rpeter3/toilet_kat_change/toilet_kat_change/toilet_kat_change.ino

#include <BLEServer.h>
#include <BLEDevice.h>
#include <BLEUtils.h>
#include <Wire.h>
#include <Adafruit_MCP23X17.h>
#include <DualMAX14870MotorShield.h> // Include the motor driver library
#include <PID_v1_bc.h>               // Heater temperature PID
#include <EEPROM.h>     // Include EEPROM library for parameter persistence
#include <esp_ota_ops.h>  // Include OTA operations for updates
#include <esp_image_format.h>
#include <nvs_flash.h>   // Include NVS for rollback state storage
#include <nvs.h>
#include <esp_system.h>  // Include for reboot functionality
#include <esp_sleep.h>    // Include for deep sleep and wake
#include <driver/rtc_io.h> // RTC GPIO for wake pin pull-up in deep sleep
#include <driver/gpio.h>   // GPIO hold during deep sleep (fan PWM pin)
#include <esp_task_wdt.h>
#include <mbedtls/md5.h> // Include for MD5 validation
#include <mbedtls/base64.h>
#include <LittleFS.h>
#include "esp_flash.h"
#include <esp_core_dump.h>
#include <esp_partition.h>
#include "ota_diag_types.h"
#define LED_PHASE_COUNT 5

// Error log (LittleFS storage partition, bounded, BLE-retrievable)
#define LOG_FILE "/errors.txt"
#define STORAGE_PARTITION_LABEL "storage"
#define MAX_LOG_SIZE 204800
#define LOG_HEADROOM 25600
#define LOG_SLEEP_TRIM_TRIGGER (MAX_LOG_SIZE - LOG_HEADROOM)
#define LOG_TRIM_TARGET 153600
#define OTA_PREP_LOG_TRIM_TARGET 102400
#define LOG_TRIM_TEMP_FILE "/errors.tmp"
#define LOG_TRIM_COPY_CHUNK 512
#define LOG_CHUNK_SIZE 450
#define LOG_LINE_MAX_LEN 200
#define CORE_CHUNK_RAW 336

//########################################################################
// Uncomment to test heater fail-safe WDT recovery: stops TWDT feed during flush while heater is on.
// Expect task-WDT reset within 5 s of heating phase, forensics on Serial/storage after reboot.
//#define SIMULATE_WDT_HANG
//########################################################################



// Pin and component definitions
const int heaterPin = 17;        // GPIO17 (HEATER)

const int buzzerPin = 38;        // GPIO38 (BUZ)
const int microswitchClosePin = 16;   // GPIO16
const int microswitchOpenPin = 15;    // GPIO15
const int controlPanelWake = 2;       // GPIO2 - wake/button1 (direct to main board)

// Motor current monitoring
const int m1CurrentPin = 8;     // GPIO8 (M1_A) - Current sense output

// Heater current monitoring
const int heaterCurrentPin = 12; // GPIO12 (HS_OUT) - Heater current sense output from INA169

// Battery voltage monitoring
const int batteryVoltagePin = 10;  // GPIO10 (VMON) - Battery voltage monitoring
const int batteryTempPin = 5;      // GPIO5 (B_TEMP) - Battery temperature monitoring

// Custom I2C instance
TwoWire myI2C = TwoWire(0);

// MCP23017 setup
Adafruit_MCP23X17 mcp;
bool mcpInitialized = false;
unsigned long lastMcpUnavailableLogMillis = 0;
const unsigned long MCP_UNAVAILABLE_LOG_INTERVAL_MS = 5000;

int lastFanState = 0;  // 0=off, 1=forward, -1=reverse (for error log context)
bool errorLogInitialized = false;

#define SERVICE_UUID "5636340f-afc7-47b1-b0a8-15bc9d7d29a5"
#define CHARACTERISTIC_UUID "c327b077-560f-46a1-8f35-b4ab0332fea0"
#define SERIAL_CHARACTERISTIC_UUID "c327b077-560f-46a1-8f35-b4ab0332fea1"
#define BLE_FRAME_START_BYTE 0x7E
#define BLE_FRAME_HEADER_SIZE 3
#define VERSION_CHARACTERISTIC_UUID "c327b077-560f-46a1-8f35-b4ab0332fea2"
#define UPDATE_SERVICE_UUID "5636340f-afc7-47b1-b0a8-15bcb9d7d29a6"
#define UPDATE_CHARACTERISTIC_UUID "c327b077-560f-46a1-8f35-b4ab0332fea3"
#define RESPONSE_CHARACTERISTIC_UUID "c327b077-560f-46a1-8f35-b4ab0332fea4"
#define PARAM_READ_CHARACTERISTIC_UUID "c327b077-560f-46a1-8f35-b4ab0332fea5"
#define PARAM_WRITE_CHARACTERISTIC_UUID "c327b077-560f-46a1-8f35-b4ab0332fea6"

// BLE Server global variables
BLECharacteristic * blue_characteristic;
BLECharacteristic * response_characteristic;
BLECharacteristic * param_read_characteristic;
BLECharacteristic * param_write_characteristic;
BLECharacteristic * serial_characteristic;
BLECharacteristic * version_characteristic;
BLECharacteristic * update_characteristic;
BLEServer * blue_server;
BLEService * update_service;
bool is_device_connected, old_device_connect = false;
bool serial_streaming_enabled = false;

// Trust handshake state (BLE_APP_MIGRATION_SPEC, BLE_HANDSHAKE_INTERFACE_SPEC)
enum TrustState {
  TRUST_STATE_UNTRUSTED = 0,
  TRUST_STATE_WAITING = 1,
  TRUST_STATE_TRUSTED = 2,
  TRUST_STATE_TIMEOUT = 3
};
static TrustState g_trustState = TRUST_STATE_UNTRUSTED;
static unsigned long g_trustStartMs = 0;
static const unsigned long TRUST_TIMEOUT_MS = 60000;  // 60s per spec

void resetTrustState();
void beginTrustWaiting();
void onTrustConfirmedByFlushButton();
void updateTrustTimeout();
bool isTrustedConnection();
void trustDoubleBeep();

// EEPROM configuration
#define EEPROM_SIZE 512
#define PARAM_START_ADDR 0
#define PARAM_MAGIC_NUMBER 0x1234
#define PARAM_COUNT 30
#define HW_VERSION_ADDR 200
#define HW_VERSION_MAGIC 0xFADE
#define FLUSH_COUNT_MAGIC_ADDR 300
#define FLUSH_COUNT_ADDR (FLUSH_COUNT_MAGIC_ADDR + sizeof(uint16_t))
#define FLUSH_COUNT_MAGIC 0xF1C5

// Hardware matrix persistence (NVS)
#define HW_MATRIX_MAGIC 0x484D4154UL  // "HMAT"
#define HW_MATRIX_SCHEMA_VERSION 1
#define HW_COMPONENT_VERSION_LEN 24
#define HW_COMPONENT_DESC_LEN 96
#define HW_COMPONENT_DATE_LEN 11  // YYYY-MM-DD + '\0'

// HWCFG transactional profile storage
#define HWCFG_MAGIC 0x48434647UL  // "HCFG"
#define HWCFG_SCHEMA_VERSION 1
#define HWCFG_PROFILE_MAX 24
#define HWCFG_PROFILE_ID_LEN 24
#define HWCFG_PROFILE_PARAM_BLOB_LEN 320
#define HWCFG_CONFIG_NAMESPACE "hwcfg"
#define HWCFG_ACTIVE_KEY "active"
#define HWCFG_LAST_GOOD_KEY "lkg"
#define HWCFG_ACTIVE_FILE "/hwcfg_active.bin"
#define HWCFG_LAST_GOOD_FILE "/hwcfg_lkg.bin"

// Version information
struct VersionInfo {
  uint16_t magic;
  uint16_t hardware_version;
  char hardware_description[32];
};

enum HardwareComponentId {
  HW_CONTROL_PANEL = 0,
  HW_HEATING_ELEMENT,
  HW_MAIN_CIRCUIT_BOARD,
  HW_VACUUM_FAN,
  HW_FEED_MOTOR,
  HW_MECHANISM_MOTOR,
  HW_THERMISTOR,
  HW_BATTERY,
  HW_FACTORY_SOFTWARE_DATE,
  HW_SOFTWARE_VERSION_NUMBER,
  HW_COMPONENT_COUNT
};

// Production: 0 = use hardware matrix (CONTROL_PANEL 5/6). Dev: pass -DCONTROL_PANEL_PINOUT_OVERRIDE=6 at build.
#ifndef CONTROL_PANEL_PINOUT_OVERRIDE
#define CONTROL_PANEL_PINOUT_OVERRIDE 0
#endif

enum ControlPanelPinout : uint8_t {
  CP_PINOUT_V5_LEGACY = 5,
  CP_PINOUT_V6 = 6
};

const int CP_V5_BTN2_MCP = 15;
const int CP_V6_BTN1_MCP = 6;
const int CP_V6_BTN2_MCP = 14;

struct HardwareComponentEntry {
  char current_version[HW_COMPONENT_VERSION_LEN];
  char current_description[HW_COMPONENT_DESC_LEN];
  char install_date[HW_COMPONENT_DATE_LEN];
  char previous_version[HW_COMPONENT_VERSION_LEN];
  char previous_description[HW_COMPONENT_DESC_LEN];
  char previous_install_date[HW_COMPONENT_DATE_LEN];
};

struct HardwareMatrix {
  uint32_t matrix_magic;
  uint16_t matrix_schema_version;
  uint16_t component_count;
  HardwareComponentEntry components[HW_COMPONENT_COUNT];
  uint32_t crc32;
};

struct HWCFGProfileEntry {
  uint8_t in_use;
  char profile_id[HWCFG_PROFILE_ID_LEN];
  char component_name[HW_COMPONENT_DESC_LEN];
  char component_version[HW_COMPONENT_VERSION_LEN];
  char params_blob[HWCFG_PROFILE_PARAM_BLOB_LEN];
};

struct HWCFGConfigStore {
  uint32_t magic;
  uint16_t schema_version;
  uint16_t profile_count;
  char active_profile_id[HWCFG_PROFILE_ID_LEN];
  char last_good_profile_id[HWCFG_PROFILE_ID_LEN];
  uint8_t active_validated;
  HWCFGProfileEntry profiles[HWCFG_PROFILE_MAX];
  uint32_t crc32;
};

//++++++++++++++++++++++++++++++++++++++++++++++++++++++++++++++++++++++++++++++++
//++++++++++++++++++++++++++++++++++++++++++++++++++++++++++++++++++++++++++++++++
//set this when building the firmware
//++++++++++++++++++++++++++++++++++++++++++++++++++++++++++++++++++++++++++++++++
//++++++++++++++++++++++++++++++++++++++++++++++++++++++++++++++++++++++++++++++++
const char* SOFTWARE_VERSION_NUMBER = "4.0.15";
const char* FACTORY_SOFTWARE_DATE = "2026-06-13";
const char* SOFTWARE_BUILD_DATE = __DATE__ " " __TIME__;

// Forward declarations
// sendSerialToBLEImpl: setValue+notify (ungated) — use only for AUTH or internal plumbing.
// sendSerialToBLE: gated on serial_streaming_enabled
void sendSerialToBLEImpl(const String& message);
void sendSerialToBLEImpl(float value);
void sendSerialToBLEImpl(int value);
void sendSerialToBLEImpl(unsigned long value);
void sendSerialToBLE(const String& message);
void sendSerialToBLE(float value);
void sendSerialToBLE(int value);
void sendSerialToBLE(unsigned long value);
void writeResponseToChannel(const String& response);
String buildParamCSV();
String buildMotorFaultStatusSnapshot();
void saveParametersToEEPROM();
void loadParametersFromEEPROM();
void loadFlushCountFromEEPROM();
bool saveFlushCountToEEPROM();
void incrementFlushCount();
void initializeHardwareVersion();
VersionInfo readHardwareVersion();
void writeHardwareVersion(uint16_t version, const char* description);
bool initializeHardwareMatrix();
String getVersionString();
String getHardwareComponentsListString();
String getHardwareComponentString(HardwareComponentId componentId);
bool setHardwareComponentByName(const String& componentName, const String& version, const String& installDate, const String& description, String& errorCode);
ControlPanelPinout getControlPanelPinout();
void configureControlPanelMcpInputs();
void configureControlPanelLedOutputs();
const int* getActiveLedPins();
int getLedPin(int uiIndex);
void logControlPanelPinout();
bool readControlPanelButton1();
bool readControlPanelButton2();
bool readControlPanelWakeLine();
bool readFlushCancelInput(bool button1Pressed, bool button2Pressed);
bool lookupHardwareComponentId(const String& componentName, HardwareComponentId& outId);
bool initializeHWCFGStore();
String handleHWCFGCommand(const String& cmd);
void enterEEPROMInvalidErrorState(const char* reason);
void initErrorLog();
void logBootCheckpoint(const char* phase);
void resetBootTiming();
void logBootTiming(const char* phase);
void captureCrashPendingRtc();
void flushPendingCrashLog();
void logCoredumpStatus();
String buildBootInfoResponse();
String readCoredumpChunk(size_t offset);
bool clearCoredumpImage();
void logError(const char* type, int code, const char* msg);
void logError(const char* type, int code, const char* msg, bool includeContext);
bool trimErrorLogToSize(size_t targetBytes);
void logDevFlush(const char* type, int code, const char* msg, bool includeContext = true);
void logDevFlushStatusTick();
void setFlushStep(int newStep, bool logTransition = true);
String readLogChunk(size_t offset);
float readBatteryVoltage();
float readBatteryVoltageQuiet();
float readHeaterCurrentQuiet();
float readBatteryTemperatureQuiet();
bool measureBatteryUnderLoad(float* vIdle, float* vLoad, int testDuty, uint16_t settleMs, const char* testTag = nullptr);
int getHeaterPwmCapForVoltage(float batteryV);
int getEffectiveHeaterPwmCap(float batteryV);
float minIdleBatteryV();
bool assessBatteryUsable(const char* tag, bool forceRefresh, bool* outFlushAllowed = nullptr);
void streamBatteryAssessReport(const char* tag);
bool isBatteryOkForHeaterTest();
bool isFlushAllowedByBattery(bool forceRefresh = false);
void applyBatteryAssessDefaults();
bool validateBatteryAssessParams();
void applyBatteryAssessParamsFromCsv(const float* parameters_list, int count);
void renderBatteryLevelLeds(int chargeLevel);
void showBatteryLevelFeedback(int chargeLevel, bool enterDisplayMode);
void logPowerTestEvent(const char* phase, const char* msg, bool includeContext = false);
void latchLowBatteryStop(const char* reason);
bool isM1MotorActive();
bool shouldSkipBootHeaterTest(const char** skipReason);
void initBrownoutStreak();
void clearBrownoutStreakOnSuccessfulBoot();
void loadMotorHomingDeferredFromNvs();
void saveMotorHomingDeferredToNvs(const char* reason);
void clearMotorHomingDeferredFromNvs();
void deferMotorHoming(const char* reason);
void clearMotorHomingDeferred();
void applyLoadedMotorHomingDeferred();
bool shouldDeferHomingAtBoot(const char** reason);
void tryStartDeferredHomingIfReady();
float readTemperature();
float readM1Current();
float readHeaterCurrent();
void maintainEEPROMErrorIndicator();
void startEEPROMWakeAlert();
bool prepareForOTA();
void notifyUpdateProgress(int percentage);
bool rollbackOTAUpdate();
bool rollbackOTAUpdateWithReason(String* errorCode);
bool rollbackOTAUpdateToFactoryWithReason(String* errorCode);
bool logOtaFactoryRollback(const char* trigger, const char* reason, String* errorCode);
String handleManualOTARollback();
String handleManualOTAFactoryRollback();
void executeFactoryRollbackFromHardware();
bool validateFirmware();
void handleOTAChunk(uint8_t* data, size_t length);
void resetOTAState();
void checkBootFailure();
void saveRollbackInfo();
void recordOtaBootAttempt();
void logOtaBootAttemptToStorage();
void incrementOtaGoodBootStreak();
void confirmOtaBootOk();
void mergeNvsLogTailToStorage();
void markOtaPendingVerify();
bool logOtaRollback(const char* trigger, const char* reason, String* errorCode);
String buildOtaDiagResponse();
bool isOnOtaTargetPartition();
void enableOTA();
void disableOTA();
void restartBLEServer();
void slowCircleLeds();
void startManualFeed();
void stopManualFeed();
void updateManualFeedRamp();
bool loadDevModeSetting();
bool saveDevModeSetting(bool enabled);
bool setDevModeEnabled(bool enabled);
String buildDevModeStatusMessage();
void logMotorFaultDebug(const char* context);
float readMainThermistorResistanceOhms();
bool isHardwareLikelyDisconnectedForUserAction();
void playHardwareNotConnectedAlert();
bool enforceHeaterToleranceGap(const char* sourceTag, bool notifyBle = true);
void initHeaterGpioSafe();
void clearHeaterRtcOnFlag();
void configureMotorAndSensorPins();
void checkHeaterBootSafety();
void initTaskWatchdog();
void feedTaskWatchdog();
void wdtCheckpoint();
void wdtCheckpoint(const char* phase);
void wdtSafeDelay(unsigned long ms);
void updateHeaterSessionRtc();
void checkHeaterRuntimeSafety();
void startMotorHoming(bool batteryPreflightPassed = false);
void updateMotorHoming();
void runHeaterSafetyBootSequence();
int readHeaterCurrentAdc();
void logAbnormalResetForensics();
void logBootStatus();
void testHeaterCurrent(bool lowBatteryAsError = false);
void initHeaterPwm();
void applyHeaterPwmDuty(int duty);
void updateHeaterPID();
void heaterOff();
void prepareFanPinsForDeepSleep();
void releaseFanPinsFromDeepSleepHold();
void initHeaterPidController();
void initCorePlatformServices();
void LEDErrorCode(int errorCode);
void stopEverything();
void flashLeds();
bool mechanismNeedsHomingAfterCancel();
void stopFlushActiveOperations();
void clearFlushStateForCancel();
void completeCancelRecoveryReady();
void beginCancelRecoveryHoming();
bool abortFlushForCancel();
bool isDeviceIdleForDualButton();
bool acceptFlushCancel(bool button1Pressed, bool button2Pressed);
void maintainCancelRecoveryLeds();

// Macros to automatically forward Serial output to BLE when streaming is enabled
#define SerialBLE_print(x) do { Serial.print(x); if(serial_streaming_enabled) sendSerialToBLEImpl(x); } while(0)
#define SerialBLE_println(x) do { Serial.println(x); if(serial_streaming_enabled) sendSerialToBLEImpl(String(x) + "\n"); } while(0)
#define SerialBLE_println_empty() do { Serial.println(); if(serial_streaming_enabled) sendSerialToBLEImpl("\n"); } while(0)

// LED pins (UI index 0-13 -> MCP pin; v6 uses 15/7 at indices 3/5 instead of v5's 14/6)
static const int ledPinsV5[] = {1, 9, 13, 14, 10, 6, 11, 12, 8, 0, 2, 3, 4, 5};
static const int ledPinsV6[] = {1, 9, 13, 15, 10, 7, 11, 12, 8, 0, 2, 3, 4, 5};
const int totalLeds = 14;
int ledIndex = 0;
bool clockwise = true; // Direction flag for LED cycling
const float HARDWARE_DISCONNECT_RESISTANCE_OHMS = 100000.0;
const float THERMISTOR_VOLTAGE_GUARD_V = 0.01;

// Timing variables
unsigned long previousMillis = 0;
unsigned long flushStartMillis = 0;
unsigned long processStartMillis = 0;
unsigned long ledLastUpdateMillis = 0;
unsigned long motorStartMillis = 0;
bool mechanismMotorRunning = false;
bool heaterOn = false;
unsigned long stepStartMillis = 0;
unsigned long timeAboveSetpointMillis = 0;   // Cumulative ms thermistor has been above K this heating phase
unsigned long lastHeaterCheckMillis = 0;     // Last millis() when we updated the time-above-K accumulator
unsigned long timeAboveCutModeTempMillis = 0;   // After cut motor: cumulative ms temp >= CUT_MODE_TEMP
unsigned long lastCutModeTempCheckMillis = 0;   // Last millis() for time-above-CUT_MODE_TEMP accumulator
unsigned long lastHeaterControlLogMillis = 0;  // Last millis() when heater control state was logged
const unsigned long HEATER_CONTROL_LOG_INTERVAL_MS = 1000;  // 1s heater debug log cadence
unsigned long lastCoolingTempLogMillis = 0;  // Last millis() when cooling temp was sent to BLE
const unsigned long COOLING_TEMP_LOG_INTERVAL_MS = 1000;  // 1s cooling temperature log cadence
const unsigned long BLE_STATUS_LOG_INTERVAL_MS = 2000;  // 2s status log cadence to avoid BLE spam
const unsigned long M1_CURRENT_LOG_INTERVAL_MS = 3000;  // 3s max-current log window
unsigned long m1CurrentLogWindowStartMillis = 0;
float m1CurrentMaxInWindow = 0.0;
bool heaterOutputOn = false;  // Physical heater output state (independent from heater phase state)
unsigned long maxHeaterWallTimeMs = 0;  // Computed once at flush start (case 0) and reused for that cycle

// Temperature setup
const int thermistorPin = 14;    // GPIO14 (IO14)
float knownResistor = 10000.0;  // Will be initialized from thermistorResistance parameter
//float knownResistor = 33000.0;  // Will be initialized from thermistorResistance parameter

const float A = 2.7807099250E-03;
const float B = 2.4294397063E-04;
const float C = 1.0810891036E-06;
//const float A = 0.003306387; //for 33k Ohm
//const float B = 0.000305051;   // for 3k ohm
//const float C = 0.000000010;//for 10K ohm


/* Parameters 
// I think these are the things Richard wants changed
const int batteryThreshold = -1; //parameters_list[0]
const float K = 60.0; //parameters_list[1]
const int F = 5; //parameters_list[2]
const long T = 50; //parameters_list[3]
const int r1 = 5; //parameters_list[4]
const int r2 = 2; //parameters_list[5]
const int backupTime = 2; //parameters_list[6]
const int r4 = 2; //parameters_list[7]
const int fanDuration = 5; //parameters_list[8]
const long H = 50; //parameters_list[9]
const float continueFeeder = 6; //parameters_list[10]
const int maxOpeningTime = 10; //parameters_list[11]
const int typicalOpeningTime = 5; //parameters_list[12] */

// Parameters (defaults: 1.5mil High Barrier Plastic from material_parameters.csv)
// Can't have global constant variables in C
int batteryThreshold = 7; //parameters_list[0] minimum usable % before flush
float K = 150.0; //parameters_list[1]
int F = 8; //parameters_list[2]
long T = 60; //parameters_list[3] - Estimated cooling time for LED pacing (seconds)
float thermistorResistance = 10000.0; // constant, not in BLE
int r2 = 2; // constant, not in BLE
float backupTime = 1.0; //parameters_list[4]
int r4 = 2; // constant, not in BLE
int fanDuration = 5; //parameters_list[5]
long H = 30; //parameters_list[6] - Time (seconds) thermistor must be above K
float continueFeeder = 6.0; //parameters_list[7]
int maxOpeningTime = 12; //parameters_list[8]
int typicalOpeningTime = 10; //parameters_list[9]
float MOTOR_CUT_TIME = 0.5; //parameters_list[10]
float CUT_MODE_HEAT_TIME = 15.0; //parameters_list[11] - Additional time (seconds) above K in cut mode
float postCoolingFanDuration = 5.0; //parameters_list[12]
float preFeedFan = 2.0; //parameters_list[13]
float fanReverseTime = 12.0; //parameters_list[14]
float fanReverseStartTime = 0.0; //parameters_list[15]
float backupTimeAfterReopen = 1.7; //parameters_list[16]
float CUT_MODE_TEMP = 150.0;      //parameters_list[17] - Temp to maintain for CUT_MODE_HEAT_TIME after cut
float heaterLowerToleranceC = 0.0; //parameters_list[18] - Turn heater ON at target-lower
float heaterUpperToleranceC = 2.0; //parameters_list[19] - Turn heater OFF at target+upper (can be negative)
float COOL_OPEN_TEMP_C = 80.0f; //parameters_list[20] - Open sealer below this thermistor temp
long MAX_COOL_WAIT_S = 180; //parameters_list[21] - Safety fallback max cooling wait (seconds)
float minLoadedBatteryV = 11.2f; //parameters_list[22]
float maxBatterySagV = 0.85f; //parameters_list[23]
float minIdleBatteryVFloor = 11.3f; //parameters_list[24]
float usableVFull = 12.4f; //parameters_list[25]
uint16_t batteryAssessSettleMs = 50; //parameters_list[26]
float heaterCapV255 = 11.6f; //parameters_list[27]
float heaterCapV170 = 11.5f; //parameters_list[28]
float heaterCapV100 = 11.4f; //parameters_list[29]
float heaterTargetTemp = 150.0;    // Active heater target (K or CUT_MODE_TEMP)

const int FLUSH_STEP_CANCEL_COOL = 14;

bool isFlushing = false;
int flushStep = 0;
bool cancelRecoveryHomingPending = false;
bool flushCancelRecoveryActive = false;
bool case5FeedExecuted = false; // Flag to prevent multiple M2 activations in case 5
bool case1FeedStarted = false; // Flag to track if M2 has started in case 1
bool case6CutMotorRun = false;  // Flag: cut motor run after H (in cut mode); then heat continues for CUT_MODE_HEAT_TIME
bool case6CutMotorRunning = false;
unsigned long case6CutMotorStartMillis = 0;
bool case6PrecoolCutRunning = false;
unsigned long case6PrecoolCutStartMillis = 0;
bool button2FeedStarted = false; // Flag to track if M2 has started when button 2 is pressed
unsigned long button2FanStartTime = 0; // Timestamp when fan starts for button 2
bool case10FanStarted = false; // Flag to track if fan has started in case 10
bool case10BackupStarted = false; // Flag to track if backup has started in case 10
unsigned long case10BackupStartTime = 0; // Track when backup starts in case 10
bool openSwitchLatched = false; // Open microswitch seen; continue post-open steps even if switch bounces
unsigned long m1CloseStartTime = 0; // Track when M1 starts closing
unsigned long m3ReverseStartTime = 0; // Track when M3 reverse starts
bool m3ReverseActive = false; // Track if M3 reverse is running
bool m3ReverseCompleted = false; // Track if M3 reverse has completed its cycle

// Cut bag functionality
bool cutBag = false;
bool button1Held = false;
unsigned long button1HoldStartTime = 0;
const int BUTTON_HOLD_TIME = 500; // 0.5 seconds
const int BUTTON_DELAY = 200; // 200ms delay before acting on single button press
unsigned long cutStartTime = 0;
unsigned long fanStartTime = 0;  // Timer for fan duration after feed button release
bool fanRunning = false;         // Flag to track if fan is running
bool cutMotorRunning = false;

// Button state tracking
bool button2WasPressed = false;
bool button1WasPressed = false;
unsigned long button1PressStartTime = 0;
unsigned long button2PressStartTime = 0;
bool button1DelayActive = false;
bool button2DelayActive = false;
bool bothButtonsPressed = false;
bool batteryDisplayMode = false;
unsigned long batteryDisplayStartTime = 0;
bool button1DisconnectAlertedForCurrentPress = false;
bool button2DisconnectAlertedForCurrentPress = false;
bool flushCancelArmed = false;
const int MANUAL_FEED_FULL_SPEED = -400;
const int MANUAL_FEED_START_SPEED = MANUAL_FEED_FULL_SPEED / 5; // 20% feed speed.
const unsigned long MANUAL_FEED_RAMP_MS = 5000;
const unsigned long FEED_LED_INTERVAL_MS = 250;
const int FEED_LED_WINDOW = 3;
bool manualFeedActive = false;
unsigned long manualFeedStartMillis = 0;
int manualFeedLastSpeed = 0;
bool feedLedPatternActive = false;
unsigned long feedLedLastUpdateMillis = 0;
int feedLedHeadIndex = 0;

// BLE auto-shutdown variables
unsigned long bleStartupTime = 0;
unsigned long bleIdleStartTime = 0;
const unsigned long BLE_TIMEOUT = 10 * 60 * 1000; // 10 minutes in milliseconds
const unsigned long INACTIVITY_SLEEP_MS = 2 * 60 * 1000;  // 2 minutes - then deep sleep

// Runtime DEV mode (persisted in NVS): when enabled, BLE stays on and inactivity sleep is disabled.
const char* DEV_MODE_NAMESPACE = "system";
const char* DEV_MODE_KEY = "dev_mode";
const char* HOMING_DEFERRED_NVS_KEY = "homing_deferred";
const char* HOMING_DEFER_REASON_NVS_KEY = "homing_defer_reason";
const size_t HOMING_DEFER_REASON_MAX = 32;
const unsigned long HOMING_RETRY_CHECK_INTERVAL_MS = 5000;
const char* HW_MATRIX_NAMESPACE = "hwmeta";
const char* HW_MATRIX_ACTIVE_KEY = "matrix";
const char* HW_MATRIX_LAST_GOOD_KEY = "matrix_lkg";
bool devModeEnabled = false;
const unsigned long DEV_FLUSH_STATUS_INTERVAL_MS = 5000;  // 0.2 Hz status snapshots during flush
unsigned long lastDevFlushStatusLogMillis = 0;
// M1/M2 fault handling controls.
bool ignoreM12Faults = false;
bool hasIgnoredM12Fault = false;
unsigned long ignoredM12FaultCount = 0;
unsigned long lastIgnoredM12FaultMillis = 0;
unsigned long lastIgnoredM12FaultLogMillis = 0;
unsigned long suppressedIgnoredM12FaultLogs = 0;
const unsigned long M12_FAULT_LOG_THROTTLE_MS = 5000;
const bool latchM12FaultAfterRecoveryFailure = true;
const uint8_t M12_FAULT_RECOVERY_MAX_ATTEMPTS = 3;
const unsigned long M12_FAULT_RECOVERY_DISABLE_MS = 25;
const unsigned long M12_FAULT_RECOVERY_SETTLE_MS = 60;
const unsigned long M12_FAULT_RECOVERY_COOLDOWN_MS = 2000;
unsigned long lastM12RecoveryCycleMillis = 0;
unsigned long m12RecoverySuccessCount = 0;
unsigned long m12RecoveryFailureCount = 0;
unsigned long suppressedM12RecoveryCycles = 0;

unsigned long lastActivityMillis = 0;
bool bleEnabled = true;

// OTA timing variables
bool otaEnabled = false;
unsigned long dualButtonHoldStartTime = 0;
unsigned long otaWindowStartTime = 0;
bool dualButtonHoldActive = false;
bool factoryRollbackHoldWarned = false;
const unsigned long DUAL_BUTTON_DEV_HOLD_MS = 10000; // 10 seconds
const unsigned long DUAL_BUTTON_FACTORY_HOLD_MS = 20000; // 20 seconds (DEV on only)
const unsigned long DUAL_BUTTON_EDGE_GUARD_MS = 300;
const unsigned long DUAL_BUTTON_RELEASE_DEBOUNCE_MS = 100;
unsigned long lastDualButtonEdgeMillis = 0;
unsigned long bothButtonsReleaseStartMillis = 0;
const unsigned long OTA_WINDOW_DURATION = 60000; // 1 minute
const unsigned long OTA_MODE_MAX_DURATION = 2 * 60 * 1000; // 2 minutes - then always exit OTA and stop circle

// Update system variables
bool updateInProgress = false;
int updateProgress = 0;

// OTA State Management
enum OTAState {
  OTA_IDLE,
  OTA_PREPARING,
  OTA_RECEIVING,
  OTA_VALIDATING,
  OTA_FINALIZING,
  OTA_ERROR,
  OTA_ROLLBACK
};

OTAState otaState = OTA_IDLE;
inline bool otaTransferInProgress() {
  return (otaState == OTA_PREPARING || otaState == OTA_RECEIVING ||
          otaState == OTA_VALIDATING || otaState == OTA_FINALIZING);
}
void publishOTAStatus(const String& status, bool notify = true);
void publishOTAErrorStatus(const char* reasonCode, const char* detail = NULL);
bool setOTAState(OTAState nextState, const char* reason);
bool isKnownOTACommand(const String& command);
void handleOTACommand(const String& command);
void checkOTATimeouts();
void abortOtaSessionAndDisconnect(const char* reasonCode);
void disconnectBleClient();
String last_update_status = "UPDATE_IDLE";
unsigned long otaStateEnteredAt = 0;
unsigned long otaLastChunkMillis = 0;
const unsigned long OTA_PREPARE_TIMEOUT_MS = 15000;
const unsigned long OTA_RECEIVE_INACTIVITY_TIMEOUT_MS = 60UL * 1000UL;
const unsigned long OTA_FINALIZE_TIMEOUT_MS = 120UL * 1000UL;
esp_ota_handle_t ota_handle = 0;
const esp_partition_t *ota_partition = NULL;
const esp_partition_t *running_partition = NULL;
const esp_partition_t *update_partition = NULL;
size_t firmware_size = 0;
size_t bytes_received = 0;
uint8_t expected_md5[16] = {0};
uint8_t calculated_md5[16] = {0};
bool rollback_required = false;
String ota_error_message = "";

// OTA Chunk buffer (BLE MTU is typically 20-512 bytes, we'll use 512 for safety)
#define OTA_CHUNK_SIZE 512
uint8_t ota_chunk_buffer[OTA_CHUNK_SIZE];
size_t chunk_sequence = 0;
bool md5_received = false;
mbedtls_md5_context md5_ctx;
bool md5_initialized = false;

// LED timing variables (flush progress pacing)
unsigned long totalSequenceTime = 0;   // Kept for debug telemetry
unsigned long ledUpdateInterval = 0;   // Kept for debug telemetry
unsigned long slowCircleLastUpdate = 0;
int slowCircleLedIndex = 0;
const unsigned long SLOW_CIRCLE_INTERVAL = 300; // 300ms per LED for slow circle
const unsigned long LED_FLUSH_VISUAL_INTERVAL_MS = 90;

enum LedPhaseSection {
  LED_PHASE_INITIAL = 0,
  LED_PHASE_HEAT_UP = 1,
  LED_PHASE_HEAT_HOLD = 2,
  LED_PHASE_COOLING = 3,
  LED_PHASE_FINAL = 4
};

int ledSectionSteps[LED_PHASE_COUNT] = {0};
int ledSectionStartIndex[LED_PHASE_COUNT] = {0};
int ledSectionEndIndex[LED_PHASE_COUNT] = {0};
unsigned long ledSectionEstimateMs[LED_PHASE_COUNT] = {0};
int ledLastSectionSeen = -1;
int ledLastFlushStepSeen = -1;
unsigned long ledHeatStartMillis = 0;
unsigned long ledCoolingStartMillis = 0;
unsigned long ledFinalStartMillis = 0;
float ledHeatStartTempC = 0.0f;
float ledHeatTargetTempC = 0.0f;
float ledCoolStartTempC = 0.0f;
float ledCoolStartRefTempC = 0.0f;

const unsigned int TIMEOUT = 15000;

int ERROR_CODE = 0;
//ERROR_CODE = 1 ==> Mechanism Motor Timeout
//ERROR_CODE = 2 ==> Low battery
//ERROR_CODE = 3 ==> Heater too hot 
//ERROR_CODE = 4 ==> Motor Fault Detected
//ERROR_CODE = 5 ==> Heater current detection failure
//ERROR_CODE = 6 ==> Heater max wall time - time above K not reached
//ERROR_CODE = 7 ==> EEPROM invalid (reflash/parameter recovery required)
//ERROR_CODE = 8 ==> Heater fail-safe fault (crash recovery, MOSFET short, absolute max on-time)
const int EEPROM_INVALID_ERROR_CODE = 7;
const int HEATER_FAILSAFE_ERROR_CODE = 8;
const int HEATER_CURRENT_ADC_THRESHOLD = 200;
const unsigned long HEATER_ABSOLUTE_MAX_ON_MS = 20UL * 60UL * 1000UL;
const unsigned long TASK_WDT_TIMEOUT_MS = 5000UL;
const uint32_t HEATER_RTC_MAGIC = 0x4854A101UL;
const uint32_t CRASH_RTC_MAGIC = 0x43525348UL;

struct HeaterSessionRtc {
  uint32_t magic;
  uint8_t heaterWasOn;
  uint8_t pendingResetReason;
  uint32_t lastSessionMillis;
  int16_t lastHeaterTempCx10;
  uint8_t lastHeaterPwm;
  int8_t lastFlushStep;
  uint8_t lastCutBag;
};

struct CrashPendingRtc {
  uint32_t magic;
  uint32_t uptimeMs;
  char lastPhase[24];
  uint8_t flushStep;
  uint8_t heaterOn;
  uint8_t pendingResetReason;
};

const uint32_t BROWNOUT_RTC_MAGIC = 0x424F0054UL;

struct BrownoutRtc {
  uint32_t magic;
  uint8_t streak;
};

RTC_NOINIT_ATTR static HeaterSessionRtc heaterRtc;
RTC_NOINIT_ATTR static CrashPendingRtc crashRtc;
RTC_NOINIT_ATTR static BrownoutRtc brownoutRtc;
static const char* g_bootPhase = "start";
static unsigned long g_bootTimingLastMs = 0;
static size_t g_coredumpSize = 0;
bool taskWatchdogInitialized = false;
unsigned long heaterOutputOnSinceMs = 0;
unsigned long heaterRuntimeMismatchLastCheckMs = 0;
int heaterRuntimeMismatchStrikes = 0;

enum MotorHomingPhase : uint8_t {
  HOMING_IDLE = 0,
  HOMING_INIT = 1,
  HOMING_PARTIAL_CLOSE = 2,
  HOMING_CLOSE_EXTRA = 3,
  HOMING_OPEN_FULL = 4
};

bool motorHomingActive = false;
uint8_t motorHomingPhase = HOMING_IDLE;
unsigned long motorHomingPhaseStartMillis = 0;
bool motorHomingStartOpenSwitchClosed = false;
bool motorHomingDeferred = false;
char motorHomingDeferReason[HOMING_DEFER_REASON_MAX] = "";
unsigned long lastHomingRetryCheckMs = 0;
static bool lastBootHeaterTestSkipped = false;
static const char* lastBootHeaterSkipReason = nullptr;
const uint16_t VIRGIN_EEPROM_MAGIC = 0xFFFF;
bool eepromErrorState = false;
bool lastEEPROMWriteVerified = false;
bool eepromWakeAlertActive = false;
unsigned long eepromWakeAlertStartMillis = 0;
const unsigned long EEPROM_WAKE_ALERT_MS = 10000;
uint32_t lifetimeFlushCount = 0;
HardwareMatrix hardwareMatrix = {};
bool hardwareMatrixInitialized = false;
HWCFGConfigStore hwcfgStore = {};
bool hwcfgStoreInitialized = false;
bool hwcfgSafeFault = false;
HardwareMatrix hardwareMatrixScratchActive = {};
HardwareMatrix hardwareMatrixScratchLastGood = {};
// HWCFG scratch/snapshot buffers kept at file scope to avoid large loopTask stack frames.
HWCFGConfigStore hwcfgScratchActive = {};
HWCFGConfigStore hwcfgScratchLastGood = {};
HWCFGConfigStore hwcfgSnapshotStore = {};
// File-scope verify buffer (~11KB); must not live on loopTask stack in saveHWCFGBlobFile.
HWCFGConfigStore hwcfgVerifyScratch = {};
HardwareMatrix hwcfgSnapshotMatrix = {};
const char* HARDWARE_COMPONENT_NAMES[HW_COMPONENT_COUNT] = {
  "CONTROL_PANEL",
  "HEATING_ELEMENT",
  "MAIN_CIRCUIT_BOARD",
  "VACUUM_FAN",
  "FEED_MOTOR",
  "MECHANISM_MOTOR",
  "THERMISTOR",
  "BATTERY",
  "FACTORY_SOFTWARE_DATE",
  "SOFTWARE_VERSION_NUMBER"
};

// Motor Driver Definitions
const uint8_t M1DIR_PIN = 1;     // GPIO1 (M1DIR)
const uint8_t M1PWM_PIN = 42;    // GPIO42 (M1PWM)
const uint8_t M1NEN_PIN = 48;    // GPIO48 (M1NEN)
const uint8_t M1NFAULT_PIN = 40; // GPIO40 (M1NFAULT)

const uint8_t M2DIR_PIN = 3;     // GPIO3 (M2DIR)
const uint8_t M2PWM_PIN = 13;    // GPIO13 (M2PWM)
const uint8_t M2NEN_PIN = 9;     // GPIO9 (M2NEN)
const uint8_t M2NFAULT_PIN = 11; // GPIO11 (M2NFAULT)

// PWM fan (replaces M3 sealer motor)
const int sealerFanPWM = 47;       // PWM input, 25 kHz
const int sealerFanPwr = 4;        // Power enable (transistor)
const int sealerFanReverse = 21;   // HIGH = reverse
const int FAN_PWM_FREQ = 25000;
const int FAN_PWM_RESOLUTION = 8;

// Heater PWM (restored PID output path)
const int HEATER_PWM_FREQ = 1000;
const int HEATER_PWM_RESOLUTION = 8;
const int HEATER_PWM_MAX = 255;
const int HEATER_TEST_START_DUTY = 64;
const float PREFLIGHT_CAP_MARGIN_V = 0.15f;
const unsigned long BATTERY_ASSESS_CACHE_MS = 120000UL;
const uint8_t RUNTIME_SAG_STRIKES = 2;
const uint8_t BROWNOUT_STREAK_LIMIT = 2;
bool heaterPwmAttached = false;

struct BatteryAssessStep {
  int duty;
  float vLoad;
  float sag;
  int heaterAdc;
  float heaterA;
};

struct BatteryAssessment {
  float vIdle;
  float vLoadWorst;
  float sagWorst;
  int capDuty;
  int usablePercent;
  bool assessPassed;
  bool flushAllowed;
  unsigned long lastAssessMs;
  bool valid;
  bool inProgress;
  uint8_t stepCount;
  BatteryAssessStep steps[3];
};

static BatteryAssessment batteryAssessment = {0.0f, 0.0f, 0.0f, 0, 0, false, false, 0UL, false, false, 0, {}};
static uint8_t runtimeSagStrikes = 0;
static unsigned long runtimeSagLastStrikeMs = 0;

// Motor shield instance - M1&M2 speed control only. Enable/fault pins are
// handled separately because this hardware has one MAX14870 per motor.
DualMAX14870MotorShield motors(M1DIR_PIN, M1PWM_PIN, M2DIR_PIN, M2PWM_PIN, M2NEN_PIN, M2NFAULT_PIN);

// Heater PID (Kp=65, Ki=0.005, Kd=5.0, sample=250ms)
double heaterSetpoint = 150.0;
double heaterInput = 0.0;
double heaterOutput = 0.0;
double heaterKp = 65.0;
double heaterKi = 0.005;
double heaterKd = 5.0;
PID heaterPid(&heaterInput, &heaterOutput, &heaterSetpoint, heaterKp, heaterKi, heaterKd, DIRECT);

bool enforceHeaterToleranceGap(const char* sourceTag, bool notifyBle) {
  if ((heaterLowerToleranceC != heaterLowerToleranceC) || (heaterUpperToleranceC != heaterUpperToleranceC)) {
    return false;
  }

  float toleranceGap = heaterUpperToleranceC - heaterLowerToleranceC;
  if (toleranceGap >= 2.0f) {
    return false;
  }

  float originalLower = heaterLowerToleranceC;
  float originalUpper = heaterUpperToleranceC;
  heaterLowerToleranceC = heaterUpperToleranceC - 2.0f;

  Serial.printf(
      "Adjusted heater tolerances (%s): lower %.3f -> %.3f, upper %.3f (enforced >= 2.0C gap)\n",
      sourceTag,
      originalLower,
      heaterLowerToleranceC,
      originalUpper);
  if (notifyBle) {
    sendSerialToBLE(
        "Adjusted heater tolerances (" + String(sourceTag) +
        "): lower set to upper-2.0C to enforce minimum 2.0C gap");
  }
  return true;
}

// Trust handshake helpers (BLE_HANDSHAKE_INTERFACE_SPEC)
void trustDoubleBeep() {
  digitalWrite(buzzerPin, HIGH);
  delay(70);
  digitalWrite(buzzerPin, LOW);
  delay(70);
  digitalWrite(buzzerPin, HIGH);
  delay(70);
  digitalWrite(buzzerPin, LOW);
}

void resetTrustState() {
  g_trustState = TRUST_STATE_UNTRUSTED;
  g_trustStartMs = 0;
  for (int i = 0; i < totalLeds; i++) {
    mcp_digitalWrite(getLedPin(i), LOW);
  }
}

void beginTrustWaiting() {
  g_trustState = TRUST_STATE_WAITING;
  g_trustStartMs = millis();
  slowCircleLedIndex = 0;
}

void onTrustConfirmedByFlushButton() {
  if (g_trustState != TRUST_STATE_WAITING) return;
  g_trustState = TRUST_STATE_TRUSTED;
  for (int i = 0; i < totalLeds; i++) {
    mcp_digitalWrite(getLedPin(i), LOW);
  }
  trustDoubleBeep();
}

void updateTrustTimeout() {
  if (g_trustState != TRUST_STATE_WAITING) return;
  if ((millis() - g_trustStartMs) >= TRUST_TIMEOUT_MS) {
    g_trustState = TRUST_STATE_TIMEOUT;
    for (int i = 0; i < totalLeds; i++) {
      mcp_digitalWrite(getLedPin(i), LOW);
    }
  }
}

bool isTrustedConnection() {
  return g_trustState == TRUST_STATE_TRUSTED;
}

// Setup BLE callbacks called onConnect and onDisconnect
class server_callbacks: public BLEServerCallbacks {
  void onConnect(BLEServer * blue_server) {
    is_device_connected = true;
    resetTrustState();
    Serial.println("Device connected!");
    sendSerialToBLE("BLE Device Connected!");
    
    // Update param read characteristic with current parameters
    if (param_read_characteristic) {
      param_read_characteristic->setValue(buildParamCSV().c_str());
      Serial.printf("Param read characteristic updated on connect\n");
      SerialBLE_println("Characteristic updated on connect");
    }
  }

  void onDisconnect(BLEServer * blue_server) {
    is_device_connected = false;
    serial_streaming_enabled = false;
    resetTrustState();
    Serial.println("Device disconnected!");
    if (isFlushing) {
      Serial.println("Parameter update on disconnect blocked - flush in progress");
      SerialBLE_println("Parameter update blocked - flush in progress");
      return;
    }

    // Apply any param write from param_write characteristic (legacy fallback)
    if (!param_write_characteristic) return;
    int message_length = param_write_characteristic->getLength();
    if (message_length <= 0) return;
    char buf[512];
    int copyLen = (message_length < (int)sizeof(buf) - 1) ? message_length : (int)sizeof(buf) - 1;
    memcpy(buf, param_write_characteristic->getData(), copyLen);
    buf[copyLen] = '\0';

    // Parse BLE comma-separated float values (20 legacy or 22 current)
    char * parameters_string = strtok(buf, ",");
    float parameters_list[100];
    int k = 0;
    while (parameters_string != NULL && k < 100) {
      char *endptr;
      parameters_list[k] = strtof(parameters_string, &endptr);
      parameters_string = strtok(NULL, ",");
      k++;
    }
    if (k >= 20) {
      batteryThreshold = (int)parameters_list[0];
      K = parameters_list[1];
      F = (int)parameters_list[2];
      T = (long)parameters_list[3];
      backupTime = parameters_list[4];
      fanDuration = (int)parameters_list[5];
      H = (long)parameters_list[6];
      continueFeeder = parameters_list[7];
      maxOpeningTime = (int)parameters_list[8];
      typicalOpeningTime = (int)parameters_list[9];
      MOTOR_CUT_TIME = parameters_list[10];
      CUT_MODE_HEAT_TIME = parameters_list[11];
      postCoolingFanDuration = parameters_list[12];
      preFeedFan = parameters_list[13];
      fanReverseTime = parameters_list[14];
      fanReverseStartTime = parameters_list[15];
      backupTimeAfterReopen = parameters_list[16];
      CUT_MODE_TEMP = parameters_list[17];
      if (k >= 20) {
        heaterLowerToleranceC = parameters_list[18];
        heaterUpperToleranceC = parameters_list[19];
        enforceHeaterToleranceGap("server_disconnect_write");
      }
      if (k >= 22) {
        COOL_OPEN_TEMP_C = parameters_list[20];
        MAX_COOL_WAIT_S = (long)parameters_list[21];
      }
      applyBatteryAssessParamsFromCsv(parameters_list, k);
      if (!validateBatteryAssessParams()) {
        applyBatteryAssessDefaults();
      }
      if (!(isFlushing && cutBag && case6CutMotorRun)) {
        heaterTargetTemp = K;
      }
    }
    
    // Save parameters to EEPROM for persistence
    saveParametersToEEPROM();
    // Keep EEPROM latch logic tied to explicit BLE parameter writes only.
    
    Serial.printf("Parameters updated! H=%ld, K=%.1f\n", H, K);
  }
};

// BLE Characteristic callback for OTA updates
class update_characteristic_callbacks: public BLECharacteristicCallbacks {
  void onWrite(BLECharacteristic *pCharacteristic) {
    if (pCharacteristic->getUUID().toString() == UPDATE_CHARACTERISTIC_UUID) {
      // Check if OTA is enabled - reject all operations if disabled
      if (!otaEnabled) {
        publishOTAStatus("OTA_DISABLED");
        Serial.println("OTA request rejected - OTA mode not enabled");
        return;
      }
      
      int message_length = pCharacteristic->getLength();
      if (message_length > 0) {
        uint8_t* data = pCharacteristic->getData();

        // Use length-aware parsing (BLE payload is not guaranteed null-terminated)
        String command = String((char*)data, (unsigned int)message_length);
        command.trim();

        if (isKnownOTACommand(command)) {
          handleOTACommand(command);
          return;
        }

        // Handle OTA chunks
        if (otaState == OTA_RECEIVING) {
          handleOTAChunk(data, message_length);
          // Restore readable status — BLE read otherwise returns last binary chunk.
          publishOTAStatus(last_update_status, false);
          return;
        }
        
        Serial.print("DEBUG: Received update command: '");
        Serial.print(command);
        Serial.println("'");
        SerialBLE_println("Unknown OTA payload while not receiving");
      }
    }
  }
};

// Serial stream (fea1): Client writes START_SERIAL/STOP_SERIAL; firmware sends via notify.
// Uses onWrite so we only process client writes, never our own setValue+notify output.
class serial_characteristic_callbacks: public BLECharacteristicCallbacks {
  void onWrite(BLECharacteristic *pCharacteristic) {
    if (pCharacteristic->getUUID().toString() != SERIAL_CHARACTERISTIC_UUID) return;
    int serial_message_length = pCharacteristic->getLength();
    if (serial_message_length <= 0) return;

    unsigned char* serial_message = pCharacteristic->getData();
    const char* payload_ptr = (const char*)serial_message;
    size_t payload_len = (size_t)serial_message_length;

    // Framed format: 0x7E, len_lo, len_hi, payload (matches Python/Android BLE frame)
    if (serial_message_length >= BLE_FRAME_HEADER_SIZE && serial_message[0] == BLE_FRAME_START_BYTE) {
      uint16_t frame_payload_len = serial_message[1] | (serial_message[2] << 8);
      if (frame_payload_len > 0 && serial_message_length >= BLE_FRAME_HEADER_SIZE + frame_payload_len) {
        payload_ptr = (const char*)(serial_message + BLE_FRAME_HEADER_SIZE);
        payload_len = frame_payload_len;
      }
    }

    String command = String(payload_ptr, payload_len);
    command.trim();

    if (command == "START_SERIAL") {
      if (!isTrustedConnection()) {
        Serial.println("Serial streaming blocked - trust handshake required");
        sendSerialToBLEImpl("AUTH_REQUIRED\n");
        writeResponseToChannel("AUTH_REQUIRED");
      } else {
        serial_streaming_enabled = true;
        Serial.println("Serial streaming enabled via BLE");
        sendSerialToBLE("Serial streaming ENABLED via BLE");
      }
    } else if (command == "STOP_SERIAL") {
      Serial.println("Serial streaming disabled via BLE");
      sendSerialToBLE("Serial streaming DISABLED via BLE");
      serial_streaming_enabled = false;
    } else {
      Serial.printf("DEBUG: Unknown serial command: '%.40s'\n", command.c_str());
    }
  }
};

// Command channel (fea0): WRITE only. Routes all responses to response channel (fea4).
class command_characteristic_callbacks: public BLECharacteristicCallbacks {
  void onWrite(BLECharacteristic *pCharacteristic) {
    if (pCharacteristic->getUUID().toString() != CHARACTERISTIC_UUID) return;
    int message_length = pCharacteristic->getLength();
    if (message_length <= 0) return;
    unsigned char* message = pCharacteristic->getData();
    String cmd = String((char*)message, (unsigned int)message_length);
    cmd.trim();
    
    if (cmd.startsWith("HWCFG_")) {
      if (!isTrustedConnection() && (cmd.startsWith("HWCFG_APPLY_CHANGE:") || cmd == "HWCFG_ROLLBACK_LAST_GOOD" || cmd.startsWith("HWCFG_PROFILE_PUT:"))) {
        writeResponseToChannel("AUTH_REQUIRED");
        Serial.println("HWCFG command blocked - trust handshake required");
        return;
      }
      String hwcfgResponse = handleHWCFGCommand(cmd);
      writeResponseToChannel(hwcfgResponse);
      Serial.printf("Processed HWCFG command '%s' -> '%s'\n", cmd.c_str(), hwcfgResponse.c_str());
      sendSerialToBLE("Processed HWCFG command");
      return;
    }
    if (cmd == "ENABLE_OTA") {
      Serial.println("Received ENABLE_OTA command via BLE");
      sendSerialToBLE("Received ENABLE_OTA command via BLE");
      enableOTA();
      writeResponseToChannel("ENABLE_OTA_ACK");
      return;
    }
    if (cmd == "OTA_ROLLBACK_PREVIOUS") {
      String rollbackResponse = handleManualOTARollback();
      writeResponseToChannel(rollbackResponse);
      Serial.printf("Processed OTA_ROLLBACK_PREVIOUS -> %s\n", rollbackResponse.c_str());
      sendSerialToBLE("Processed OTA_ROLLBACK_PREVIOUS");
      if (rollbackResponse == "OTA_ROLLBACK_ACK:REBOOTING") {
        delay(500);
        esp_restart();
      }
      return;
    }
    if (cmd == "OTA_ROLLBACK_FACTORY") {
      String rollbackResponse = handleManualOTAFactoryRollback();
      writeResponseToChannel(rollbackResponse);
      Serial.printf("Processed OTA_ROLLBACK_FACTORY -> %s\n", rollbackResponse.c_str());
      sendSerialToBLE("Processed OTA_ROLLBACK_FACTORY");
      if (rollbackResponse == "OTA_ROLLBACK_FACTORY_ACK:REBOOTING") {
        delay(500);
        esp_restart();
      }
      return;
    }
    if (cmd == "GET_DEV_MODE") {
      String statusMessage = buildDevModeStatusMessage();
      writeResponseToChannel(statusMessage);
      Serial.printf("Processed GET_DEV_MODE, returned %s\n", statusMessage.c_str());
      sendSerialToBLE("Processed GET_DEV_MODE");
      return;
    }
    if (cmd == "GET_FLUSH_COUNT") {
      String flushCountMessage = String("FLUSH_COUNT:") + String((unsigned long)lifetimeFlushCount);
      writeResponseToChannel(flushCountMessage);
      Serial.printf("Processed GET_FLUSH_COUNT, returned %s\n", flushCountMessage.c_str());
      sendSerialToBLE("Processed GET_FLUSH_COUNT");
      return;
    }
    if (cmd == "GET_BATTERY") {
      bool flushAllowed = false;
      assessBatteryUsable("get_battery", false, &flushAllowed);
      int level = batteryAssessment.valid ? batteryAssessment.usablePercent : 0;
      float batteryVoltage = batteryAssessment.valid ? batteryAssessment.vIdle : readBatteryVoltageQuiet();
      String batteryMessage = String("BATTERY:") + String(level) + "," + String(batteryVoltage, 2) + "V";
      writeResponseToChannel(batteryMessage);
      Serial.printf("Processed GET_BATTERY, returned %s\n", batteryMessage.c_str());
      sendSerialToBLE("Processed GET_BATTERY");
      return;
    }
    if (cmd == "GET_HW_MATRIX") {
      if (!hardwareMatrixInitialized && !initializeHardwareMatrix()) {
        writeResponseToChannel("HW_MATRIX_ERR:INIT_FAIL");
        sendSerialToBLE("GET_HW_MATRIX failed: init");
        return;
      }
      String response = getHardwareComponentsListString();
      writeResponseToChannel(response);
      Serial.printf("Processed GET_HW_MATRIX, returned %s\n", response.c_str());
      sendSerialToBLE("Processed GET_HW_MATRIX");
      return;
    }
    if (cmd.startsWith("GET_HW_COMPONENT:")) {
      if (!hardwareMatrixInitialized && !initializeHardwareMatrix()) {
        writeResponseToChannel("HW_COMPONENT_ERR:INIT_FAIL");
        sendSerialToBLE("GET_HW_COMPONENT failed: init");
        return;
      }
      String componentName = cmd.substring(String("GET_HW_COMPONENT:").length());
      componentName.trim();
      HardwareComponentId componentId;
      if (!lookupHardwareComponentId(componentName, componentId)) {
        writeResponseToChannel("HW_COMPONENT_ERR:UNKNOWN_COMPONENT");
        Serial.printf("Rejected GET_HW_COMPONENT with unknown component: %s\n", componentName.c_str());
        sendSerialToBLE("GET_HW_COMPONENT rejected: unknown component");
        return;
      }
      String response = getHardwareComponentString(componentId);
      writeResponseToChannel(response);
      sendSerialToBLE("Processed GET_HW_COMPONENT");
      return;
    }
    if (cmd.startsWith("SET_HW_COMPONENT:")) {
      if (!isTrustedConnection()) {
        writeResponseToChannel("AUTH_REQUIRED");
        Serial.println("SET_HW_COMPONENT blocked - trust handshake required");
        return;
      }
      String payload = cmd.substring(String("SET_HW_COMPONENT:").length());
      int firstSep = payload.indexOf(':');
      int secondSep = (firstSep >= 0) ? payload.indexOf(':', firstSep + 1) : -1;
      int thirdSep = (secondSep >= 0) ? payload.indexOf(':', secondSep + 1) : -1;
      if (firstSep < 0 || secondSep < 0 || thirdSep < 0) {
        writeResponseToChannel("SET_HW_COMPONENT_ERR:BAD_FORMAT");
        sendSerialToBLE("SET_HW_COMPONENT rejected: bad format");
        return;
      }
      String componentName = payload.substring(0, firstSep);
      String version = payload.substring(firstSep + 1, secondSep);
      String installDate = payload.substring(secondSep + 1, thirdSep);
      String description = payload.substring(thirdSep + 1);
      componentName.trim();
      String errorCode;
      if (!setHardwareComponentByName(componentName, version, installDate, description, errorCode)) {
        String errResponse = String("SET_HW_COMPONENT_ERR:") + errorCode;
        writeResponseToChannel(errResponse);
        Serial.printf("SET_HW_COMPONENT failed for %s: %s\n", componentName.c_str(), errorCode.c_str());
        sendSerialToBLE("SET_HW_COMPONENT failed");
        return;
      }
      String ack = String("SET_HW_COMPONENT_ACK:") + componentName;
      writeResponseToChannel(ack);
      sendSerialToBLE("SET_HW_COMPONENT applied");
      return;
    }
    updateTrustTimeout();
    if (cmd == "TRUST_START") {
      if (g_trustState == TRUST_STATE_TRUSTED) {
        writeResponseToChannel("TRUST_CONFIRMED");
        return;
      }
      beginTrustWaiting();
      writeResponseToChannel("TRUST_WAITING");
      return;
    }
    if (cmd == "TRUST_STATUS") {
      if (g_trustState == TRUST_STATE_TRUSTED) {
        writeResponseToChannel("TRUST_CONFIRMED");
        return;
      }
      if (g_trustState == TRUST_STATE_TIMEOUT) {
        writeResponseToChannel("TRUST_TIMEOUT");
        return;
      }
      if (g_trustState == TRUST_STATE_WAITING) {
        writeResponseToChannel("TRUST_WAITING");
        return;
      }
      writeResponseToChannel("TRUST_TIMEOUT");
      return;
    }
    if (cmd == "TRUST_CANCEL") {
      resetTrustState();
      writeResponseToChannel("TRUST_CANCEL_ACK");
      return;
    }
    if (cmd == "GET_LOGS" || cmd.startsWith("GET_LOGS:")) {
      size_t offset = 0;
      if (cmd.startsWith("GET_LOGS:")) {
        offset = (size_t)cmd.substring(9).toInt();
      }
      String response = readLogChunk(offset);
      writeResponseToChannel(response);
      Serial.printf("Processed GET_LOGS offset=%u -> %s\n", (unsigned)offset, response.substring(0, 60).c_str());
      sendSerialToBLE("Processed GET_LOGS");
      return;
    }
    if (cmd == "GET_BOOT_INFO") {
      String response = buildBootInfoResponse();
      writeResponseToChannel(response);
      Serial.printf("Processed GET_BOOT_INFO -> %s\n", response.c_str());
      sendSerialToBLE("Processed GET_BOOT_INFO");
      return;
    }
    if (cmd == "GET_COREDUMP" || cmd.startsWith("GET_COREDUMP:")) {
      size_t offset = 0;
      if (cmd.startsWith("GET_COREDUMP:")) {
        offset = (size_t)cmd.substring(13).toInt();
      }
      String response = readCoredumpChunk(offset);
      writeResponseToChannel(response);
      Serial.printf("Processed GET_COREDUMP offset=%u -> %s\n", (unsigned)offset, response.substring(0, 60).c_str());
      sendSerialToBLE("Processed GET_COREDUMP");
      return;
    }
    if (cmd == "CLEAR_COREDUMP") {
      bool cleared = clearCoredumpImage();
      writeResponseToChannel(cleared ? "COREDUMP_CLEARED" : "COREDUMP_CLEAR_ERR");
      Serial.println(cleared ? "Processed CLEAR_COREDUMP" : "CLEAR_COREDUMP failed");
      sendSerialToBLE(cleared ? "Processed CLEAR_COREDUMP" : "CLEAR_COREDUMP failed");
      return;
    }
    if (cmd == "GET_OTA_DIAG") {
      String response = buildOtaDiagResponse();
      writeResponseToChannel(response);
      Serial.printf("Processed GET_OTA_DIAG -> %s\n", response.substring(0, 80).c_str());
      sendSerialToBLE("Processed GET_OTA_DIAG");
      return;
    }
    if (cmd.startsWith("SET_DEV_MODE:")) {
      String valueString = cmd.substring(String("SET_DEV_MODE:").length());
      valueString.trim();
      if (valueString != "0" && valueString != "1") {
        writeResponseToChannel("SET_DEV_MODE_ERR:INVALID_VALUE");
        Serial.printf("Rejected SET_DEV_MODE with invalid value: '%s'\n", valueString.c_str());
        sendSerialToBLE("SET_DEV_MODE rejected: invalid value");
        return;
      }
      bool requestedValue = (valueString == "1");
      if (!setDevModeEnabled(requestedValue)) {
        writeResponseToChannel("SET_DEV_MODE_ERR:PERSIST_FAIL");
        sendSerialToBLE("SET_DEV_MODE failed: persist error");
        return;
      }
      String ack = String("SET_DEV_MODE_ACK:") + String(devModeEnabled ? 1 : 0);
      writeResponseToChannel(ack);
      sendSerialToBLE("SET_DEV_MODE applied");
      return;
    }
    // Unknown command - param writes go to param_write characteristic (fea6)
    writeResponseToChannel("UNKNOWN_COMMAND:" + cmd.substring(0, 40));
    Serial.printf("Unknown command on command channel: '%.40s'\n", cmd.c_str());
  }
};

// Param read channel (fea5): READ only. Returns 30-float CSV or AUTH_REQUIRED if not trusted.
class param_read_characteristic_callbacks: public BLECharacteristicCallbacks {
  void onRead(BLECharacteristic *pCharacteristic) {
    if (pCharacteristic->getUUID().toString() == PARAM_READ_CHARACTERISTIC_UUID) {
      if (!isTrustedConnection()) {
        pCharacteristic->setValue("AUTH_REQUIRED");
        Serial.println("Param read blocked - trust handshake required");
        return;
      }
      pCharacteristic->setValue(buildParamCSV().c_str());
      Serial.printf("Param read - returning %s\n", buildParamCSV().c_str());
    }
  }
};

// Param write channel (fea6): WRITE only. Parses 30-float CSV, applies params, writes ack to response channel.
class param_write_characteristic_callbacks: public BLECharacteristicCallbacks {
  void onWrite(BLECharacteristic *pCharacteristic) {
    if (pCharacteristic->getUUID().toString() != PARAM_WRITE_CHARACTERISTIC_UUID) return;
    int message_length = pCharacteristic->getLength();
    if (message_length <= 0) return;
    
    if (!isTrustedConnection()) {
      writeResponseToChannel("AUTH_REQUIRED");
      Serial.println("Parameter update blocked - trust handshake required");
      SerialBLE_println("Parameter update blocked - trust handshake required");
      return;
    }
    if (isFlushing) {
      writeResponseToChannel("PARAM_UPDATE_BLOCKED_FLUSH");
      Serial.println("Parameter update blocked - flush in progress");
      SerialBLE_println("Parameter update blocked - flush in progress");
      return;
    }
    
    // Copy payload (strtok mutates)
    char buf[512];
    int copyLen = (message_length < (int)sizeof(buf) - 1) ? message_length : (int)sizeof(buf) - 1;
    memcpy(buf, pCharacteristic->getData(), copyLen);
    buf[copyLen] = '\0';
    
    char * parameters_string = strtok(buf, ",");
    float parameters_list[100];
    int k = 0;
    while (parameters_string != NULL && k < 100) {
      char *endptr;
      parameters_list[k] = strtof(parameters_string, &endptr);
      parameters_string = strtok(NULL, ",");
      k++;
    }
    
    if (k != PARAM_COUNT) {
      writeResponseToChannel("PARAM_WRITE_ERR:BAD_FORMAT");
      Serial.printf("Param write rejected: expected %d values, got %d\n", PARAM_COUNT, k);
      return;
    }
    
    batteryThreshold = (int)parameters_list[0];
    K = parameters_list[1];
    F = (int)parameters_list[2];
    T = (long)parameters_list[3];
    backupTime = parameters_list[4];
    fanDuration = (int)parameters_list[5];
    H = (long)parameters_list[6];
    continueFeeder = parameters_list[7];
    maxOpeningTime = (int)parameters_list[8];
    typicalOpeningTime = (int)parameters_list[9];
    MOTOR_CUT_TIME = parameters_list[10];
    CUT_MODE_HEAT_TIME = parameters_list[11];
    postCoolingFanDuration = parameters_list[12];
    preFeedFan = parameters_list[13];
    fanReverseTime = parameters_list[14];
    fanReverseStartTime = parameters_list[15];
    backupTimeAfterReopen = parameters_list[16];
    CUT_MODE_TEMP = parameters_list[17];
    heaterLowerToleranceC = parameters_list[18];
    heaterUpperToleranceC = parameters_list[19];
    enforceHeaterToleranceGap("param_write");
    COOL_OPEN_TEMP_C = parameters_list[20];
    MAX_COOL_WAIT_S = (long)parameters_list[21];
    applyBatteryAssessParamsFromCsv(parameters_list, k);
    if (!validateBatteryAssessParams()) {
      writeResponseToChannel("PARAM_WRITE_ERR:BAD_FORMAT");
      Serial.println("Param write rejected: invalid battery assessment parameters");
      loadParametersFromEEPROM();
      return;
    }
    if (!(isFlushing && cutBag && case6CutMotorRun)) {
      heaterTargetTemp = K;
    }
    
    saveParametersToEEPROM();
    if (eepromErrorState) {
      if (lastEEPROMWriteVerified) {
        eepromErrorState = false;
        eepromWakeAlertActive = false;
        if (ERROR_CODE == EEPROM_INVALID_ERROR_CODE) ERROR_CODE = 0;
        Serial.println("EEPROM recovery successful from BLE parameter write.");
        sendSerialToBLE("EEPROM RECOVERED - latched error cleared");
      } else {
        Serial.println("EEPROM recovery attempt failed - still in EEPROM error state");
        sendSerialToBLE("EEPROM RECOVERY FAILED - write not verified");
      }
    }
    
    if (param_read_characteristic) {
      param_read_characteristic->setValue(buildParamCSV().c_str());
    }
    writeResponseToChannel("PARAM_WRITE_ACK");
    Serial.printf("Parameters updated via param write! H=%ld, K=%.1f\n", H, K);
    SerialBLE_print("Parameters updated! H=");
    SerialBLE_print((int)H);
    SerialBLE_print(", K=");
    SerialBLE_println(K);
  }
};

ControlPanelPinout getControlPanelPinout() {
  if (CONTROL_PANEL_PINOUT_OVERRIDE == 5) {
    return CP_PINOUT_V5_LEGACY;
  }
  if (CONTROL_PANEL_PINOUT_OVERRIDE == 6) {
    return CP_PINOUT_V6;
  }
  if (hardwareMatrixInitialized) {
    const char* ver = hardwareMatrix.components[HW_CONTROL_PANEL].current_version;
    if (ver[0] == '6' && ver[1] == '\0') {
      return CP_PINOUT_V6;
    }
  }
  return CP_PINOUT_V5_LEGACY;
}

void configureControlPanelMcpInputs() {
  if (!mcpInitialized) {
    return;
  }
  if (getControlPanelPinout() == CP_PINOUT_V6) {
    mcp.pinMode(CP_V6_BTN1_MCP, INPUT_PULLUP);
    mcp.pinMode(CP_V6_BTN2_MCP, INPUT_PULLUP);
  } else {
    mcp.pinMode(CP_V5_BTN2_MCP, INPUT_PULLUP);
  }
}

const int* getActiveLedPins() {
  return getControlPanelPinout() == CP_PINOUT_V6 ? ledPinsV6 : ledPinsV5;
}

int getLedPin(int uiIndex) {
  if (uiIndex < 0 || uiIndex >= totalLeds) {
    return getActiveLedPins()[0];
  }
  return getActiveLedPins()[uiIndex];
}

void configureControlPanelLedOutputs() {
  if (!mcpInitialized) {
    return;
  }
  for (int i = 0; i < totalLeds; i++) {
    int pin = getLedPin(i);
    mcp.pinMode(pin, OUTPUT);
    mcp.digitalWrite(pin, LOW);
  }
}

// Function to initialize the MCP23017 for output and input
void mcp_setup() {
  logBootTiming("mcp_start");
  delay(200);  // Allow power rail and I2C bus to settle after reset
  logBootTiming("mcp_rail_settle_done");
  // ✅ Use GPIO6 for SDA and GPIO7 for SCL
  myI2C.begin(6, 7, 20000);
  myI2C.setTimeOut(50);

  // Retry MCP startup to survive first-boot rail/I2C bring-up timing.
  const int maxAttempts = 20;
  const unsigned long retryDelayMs = 100;
  mcpInitialized = false;
  for (int attempt = 1; attempt <= maxAttempts; attempt++) {
    unsigned long attemptStart = millis();
    if (mcp.begin_I2C(0x20, &myI2C)) {
      mcpInitialized = true;
      Serial.printf("MCP23017 Initialized Successfully on attempt %d/%d.\n", attempt, maxAttempts);
      char msg[48];
      snprintf(msg, sizeof(msg), "mcp_ok_attempt_%d,%lums", attempt, millis() - attemptStart);
      logBootTiming(msg);
      break;
    }
    char msg[48];
    snprintf(msg, sizeof(msg), "mcp_fail_attempt_%d,%lums", attempt, millis() - attemptStart);
    Serial.printf("WARNING: MCP23017 init attempt %d/%d failed (%lums).\n",
                  attempt, maxAttempts, millis() - attemptStart);
    logBootTiming(msg);
    delay(retryDelayMs);
  }

  if (!mcpInitialized) {
    Serial.println("ERROR: MCP23017 unavailable after retries - continuing without expander.");
    logBootTiming("mcp_unavailable");
    if (errorLogInitialized) {
      logError("mcp", 0, "MCP_UNAVAILABLE", false);
    }
    return;
  }

  logBootTiming("mcp_configure_start");
  configureControlPanelMcpInputs();
  configureControlPanelLedOutputs();
  logBootTiming("mcp_configure_done");
}

// Function to write a value to a specific MCP23017 pin
void mcp_digitalWrite(int pin, int value) {
  if (!mcpInitialized) {
    return;
  }
  mcp.digitalWrite(pin, value);
}

// Function to read from a specific MCP23017 pin
int mcp_digitalRead(int pin) {
  if (!mcpInitialized) {
    unsigned long now = millis();
    if (lastMcpUnavailableLogMillis == 0 || (now - lastMcpUnavailableLogMillis >= MCP_UNAVAILABLE_LOG_INTERVAL_MS)) {
      Serial.println("WARNING: MCP23017 read while unavailable; returning HIGH.");
      lastMcpUnavailableLogMillis = now;
    }
    return HIGH;
  }
  return mcp.digitalRead(pin);
}

void logControlPanelPinout() {
  if (getControlPanelPinout() == CP_PINOUT_V6) {
    Serial.println("Control panel pinout: v6 (MCP6 + MCP14, wake GPIO2); LEDs use v6 map");
    SerialBLE_println("Control panel pinout: v6 (MCP6 + MCP14, wake GPIO2); LEDs use v6 map");
  } else {
    Serial.println("Control panel pinout: v5 legacy (GPIO2 + MCP15); LEDs use v5 map");
    SerialBLE_println("Control panel pinout: v5 legacy (GPIO2 + MCP15); LEDs use v5 map");
  }
}

bool readControlPanelButton1() {
  ControlPanelPinout pinout = getControlPanelPinout();
  if (pinout == CP_PINOUT_V6) {
    return mcp_digitalRead(CP_V6_BTN1_MCP) == LOW;
  }
  return digitalRead(controlPanelWake) == LOW;
}

bool readControlPanelButton2() {
  ControlPanelPinout pinout = getControlPanelPinout();
  if (pinout == CP_PINOUT_V6) {
    return mcp_digitalRead(CP_V6_BTN2_MCP) == LOW;
  }
  return mcp_digitalRead(CP_V5_BTN2_MCP) == LOW;
}

bool readControlPanelWakeLine() {
  return digitalRead(controlPanelWake) == LOW;
}

bool readFlushCancelInput(bool button1Pressed, bool button2Pressed) {
  return button1Pressed || button2Pressed || readControlPanelWakeLine();
}

// Function to initialize the BLE Server
void server_setup(bool includeOTA = false) {
  Serial.println("Setting up Bluetooth Low Energy.");
  // Create a BLE Device
  BLEDevice::init("ESP32 Toilet");
  
  // Set up the BLE Device as a server
  wdtCheckpoint();
  blue_server = BLEDevice::createServer();
  wdtCheckpoint();
  
  // Create a new server_callbacks() object
  blue_server->setCallbacks(new server_callbacks());
  // Set up a service for the server
  BLEService * blue_service = blue_server->createService(SERVICE_UUID);
  
  // Command channel (fea0): WRITE only - client writes commands
  blue_characteristic = blue_service->createCharacteristic(
                                                          CHARACTERISTIC_UUID, 
                                                          BLECharacteristic::PROPERTY_WRITE
                                                        );
  blue_characteristic->setCallbacks(new command_characteristic_callbacks());
  
  // Response channel (fea4): READ only - client reads command/param responses
  response_characteristic = blue_service->createCharacteristic(
                                                              RESPONSE_CHARACTERISTIC_UUID,
                                                              BLECharacteristic::PROPERTY_READ
                                                            );
  response_characteristic->setValue("READY");
  
  // Param read channel (fea5): READ only - 30-float CSV snapshot
  param_read_characteristic = blue_service->createCharacteristic(
                                                                PARAM_READ_CHARACTERISTIC_UUID,
                                                                BLECharacteristic::PROPERTY_READ
                                                              );
  param_read_characteristic->setCallbacks(new param_read_characteristic_callbacks());
  param_read_characteristic->setValue(buildParamCSV().c_str());
  
  // Param write channel (fea6): WRITE only - client writes 30-float CSV
  param_write_characteristic = blue_service->createCharacteristic(
                                                                PARAM_WRITE_CHARACTERISTIC_UUID,
                                                                BLECharacteristic::PROPERTY_WRITE
                                                              );
  param_write_characteristic->setCallbacks(new param_write_characteristic_callbacks());
  
  Serial.printf("DEBUG: H value at BLE init: %ld\n", H);
  
  // Create serial streaming characteristic
  serial_characteristic = blue_service->createCharacteristic(
                                                             SERIAL_CHARACTERISTIC_UUID,
                                                             BLECharacteristic::PROPERTY_READ |
                                                             BLECharacteristic::PROPERTY_WRITE |
                                                             BLECharacteristic::PROPERTY_NOTIFY
                                                           );
  serial_characteristic->setCallbacks(new serial_characteristic_callbacks());
  serial_characteristic->setValue("Serial streaming ready");
  
  // Create version characteristic with dummy value
  version_characteristic = blue_service->createCharacteristic(
                                                             VERSION_CHARACTERISTIC_UUID,
                                                             BLECharacteristic::PROPERTY_READ |
                                                             BLECharacteristic::PROPERTY_NOTIFY
                                                           );
  version_characteristic->setValue("v1.0");
  Serial.println("Version characteristic set to dummy value");

  // Create update characteristic as part of main service (OTA commands; Python client uses it after ENABLE_OTA)
  Serial.println("Creating update characteristic in main service...");
  update_characteristic = blue_service->createCharacteristic(
    UPDATE_CHARACTERISTIC_UUID,
    BLECharacteristic::PROPERTY_READ |
    BLECharacteristic::PROPERTY_WRITE
  );
  update_characteristic->setCallbacks(new update_characteristic_callbacks());
  update_characteristic->setValue("READY");
  Serial.println("Update characteristic created and callback set");
  update_service = NULL;

  // Starts the service on the server
  blue_service->start();

  // Starts broadcasting so any devices can now find it and connect
  wdtCheckpoint();
  BLEAdvertising * blue_advert = blue_server->getAdvertising();
  blue_advert->addServiceUUID(SERVICE_UUID);
  blue_advert->setScanResponse(true);
  // Functions that help with iPhone connections issue
  blue_advert->setMinPreferred(0x06);
  blue_advert->setMinPreferred(0x12);


  // Once the server starts advertising, the client can now see the server as it's visible to everyone
  BLEDevice::startAdvertising();


  Serial.print("ESP32 MAC ADDRESS: ");
  // Outputs the MAC Address of the ESP32 Board
  Serial.println(BLEDevice::getAddress().toString());
  Serial.println("Characteristic defined! Now your client can read it!");
}
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
void loop() {
  
  if (lastActivityMillis == 0) {
    lastActivityMillis = millis();
  }
  maintainEEPROMErrorIndicator();

  // OTA mode handling
  if (otaEnabled) {
    // OTA mode is active - run slow circle animation
    slowCircleLeds();
    checkOTATimeouts();
    
    // Check if OTA window has expired - never expire while transfer in progress
    unsigned long currentMillis = millis();
    if (!otaTransferInProgress()) {
      if (currentMillis - otaWindowStartTime >= OTA_MODE_MAX_DURATION) {
        // 2 minutes reached - always exit OTA and stop circle
        Serial.println("OTA mode max duration (2 min) reached - disabling OTA and restarting BLE");
        restartBLEServer();
        dualButtonHoldActive = false;
      } else if (currentMillis - otaWindowStartTime >= OTA_WINDOW_DURATION) {
        // 1 minute - expire only if no OTA connection
        bool hasOTAConnection = (is_device_connected && update_characteristic != NULL);
        if (!hasOTAConnection) {
          Serial.println("OTA window expired with no connections - disabling OTA and restarting BLE");
          restartBLEServer();
          dualButtonHoldActive = false;
        } else {
          Serial.println("OTA connection active - keeping OTA mode enabled");
        }
      }
    }
  }

  // Trust handshake: LED circle while waiting for GPIO2 wake line press
  if (g_trustState == TRUST_STATE_WAITING) {
    slowCircleLeds();
  }
  
  // Keep BLE alive while serial streaming or flush is active. When idle (not streaming),
  // allow timeout after BLE_TIMEOUT even if a client remains connected.
  if (serial_streaming_enabled || isFlushing) {
    bleIdleStartTime = millis();
  }

  // Check for BLE timeout during idle (no serial streaming) - never shut down during OTA transfer.
  if (!devModeEnabled && bleEnabled && !otaTransferInProgress() && !serial_streaming_enabled && !isFlushing &&
      (millis() - bleIdleStartTime > BLE_TIMEOUT)) {
    Serial.println("BLE shutting down after 10 minutes to save power");
    SerialBLE_println("BLE shutting down after 10 minutes to save power");
    
    // Disconnect all clients and stop advertising
    if (blue_server) {
      is_device_connected = false;
      serial_streaming_enabled = false;
      blue_server->getAdvertising()->stop();
      BLEDevice::deinit();
    }
    
    bleEnabled = false;
    dualButtonHoldActive = false; // Reset hold timer when BLE shuts down
    Serial.println("BLE disabled - manually restart device to re-enable");
    // Continue with control panel operations even when BLE is disabled
  }
  
  // BLE-specific operations - only run if BLE is enabled and OTA is not active
  if (bleEnabled && !otaEnabled) {
    if (!is_device_connected) {
    //Serial.println("hi");
  } else {
    // Send periodic status when connected
    static unsigned long lastStatusPrint = 0;
    if (millis() - lastStatusPrint > 5000) { // Every 5 seconds
      lastStatusPrint = millis();
      Serial.println("BLE Connected - System Running");
      SerialBLE_print("System Status: Running - " + String(millis() / 1000) + "s");
      yield();  // Space between rapid BLE notifies to avoid LoadProhibited
      String motorFaultStatus = "Motor Fault Status: " + buildMotorFaultStatusSnapshot();
      Serial.println(motorFaultStatus);
      SerialBLE_print(motorFaultStatus);
    }
  }
  if (!is_device_connected && old_device_connect) {
    delay(500);
    blue_server->startAdvertising();
    old_device_connect = is_device_connected;
  }
  if (is_device_connected && !old_device_connect) {
    old_device_connect = is_device_connected;
  }
  
  } // End of BLE-specific operations

  if (eepromWakeAlertActive) {
    if (millis() - eepromWakeAlertStartMillis < EEPROM_WAKE_ALERT_MS) {
      maintainEEPROMErrorIndicator();
      feedTaskWatchdog();
      delay(1);
      return;
    }
    eepromWakeAlertActive = false;
    Serial.println("EEPROM wake alert ended. Normal operation resumed.");
    sendSerialToBLE("EEPROM wake alert ended. Normal operation resumed");
  }

  updateMotorHoming();
  tryStartDeferredHomingIfReady();
  updateHeaterSessionRtc();
  checkHeaterRuntimeSafety();
  
  // OTA update handling is now done via update_characteristic_callbacks class
  // Read button states
  bool button1Pressed = readControlPanelButton1();
  bool button2Pressed = readControlPanelButton2();
  bool bothButtonsPressedNow = button1Pressed && button2Pressed;
  bool flushCancelInputActive = readFlushCancelInput(button1Pressed, button2Pressed);
  if (button1Pressed || button2Pressed || flushCancelInputActive) {
    lastActivityMillis = millis();
  }

  // Single-button press cancels dual-button battery display / DEV hold latch.
  if (!bothButtonsPressedNow && !bothButtonsPressed && (button1Pressed != button2Pressed)) {
    dualButtonHoldActive = false;
    factoryRollbackHoldWarned = false;
    if (batteryDisplayMode) {
      batteryDisplayMode = false;
      for (int i = 0; i < totalLeds; i++) {
        mcp_digitalWrite(getLedPin(i), LOW);
      }
    }
  }

  // Dual-button edge (before flush block may clear single-button states)
  if (bothButtonsPressedNow && isHardwareLikelyDisconnectedForUserAction()) {
    if (!bothButtonsPressed) {
      SerialBLE_println("Hardware not connected (thermistor open) - battery read blocked");
      playHardwareNotConnectedAlert();
    }
    bothButtonsPressed = true;
    dualButtonHoldActive = false;
    batteryDisplayMode = false;
  } else if (bothButtonsPressedNow && !bothButtonsPressed && !otaEnabled) {
    lastDualButtonEdgeMillis = millis();
    bothButtonsReleaseStartMillis = 0;
    if (isDeviceIdleForDualButton()) {
      SerialBLE_println("Both buttons pressed - Stopping all operations and displaying battery charge level");

      stopEverything();

      button1WasPressed = button1Pressed;
      button2WasPressed = button2Pressed;
      button1Held = false;
      button1DelayActive = false;
      button2DelayActive = false;
      button2FeedStarted = false;

      bothButtonsPressed = true;
      batteryDisplayMode = true;
      batteryDisplayStartTime = millis();
      dualButtonHoldStartTime = millis();
      dualButtonHoldActive = true;
      factoryRollbackHoldWarned = false;
      displayBatteryChargeLevel();
    } else if (isFlushing) {
      bool continueFlushRecovery = acceptFlushCancel(button1Pressed, button2Pressed);
      bothButtonsPressed = true;
      feedTaskWatchdog();
      delay(1);
      if (!continueFlushRecovery) {
        return;
      }
    } else {
      SerialBLE_println("Both buttons pressed - stopping active operations");
      stopEverything();

      button1WasPressed = button1Pressed;
      button2WasPressed = button2Pressed;
      button1Held = false;
      button1DelayActive = false;
      button2DelayActive = false;
      button2FeedStarted = false;

      bothButtonsPressed = true;
      dualButtonHoldActive = false;
      batteryDisplayMode = false;
    }
  } else if (bothButtonsPressedNow && bothButtonsPressed && !otaEnabled) {
    unsigned long currentMillis = millis();
    if (dualButtonHoldActive) {
      unsigned long holdMs = currentMillis - dualButtonHoldStartTime;
      if (devModeEnabled) {
        if (holdMs >= DUAL_BUTTON_FACTORY_HOLD_MS) {
          executeFactoryRollbackFromHardware();
          dualButtonHoldActive = false;
          batteryDisplayMode = false;
          bothButtonsPressed = false;
          factoryRollbackHoldWarned = false;
          for (int i = 0; i < totalLeds; i++) {
            mcp_digitalWrite(getLedPin(i), LOW);
          }
        } else if (holdMs >= DUAL_BUTTON_DEV_HOLD_MS && !factoryRollbackHoldWarned) {
          factoryRollbackHoldWarned = true;
          Serial.println("DEV on dual hold 10s: factory rollback warning (hold 20s total)");
          sendSerialToBLE("DEV_MODE_FACTORY_HOLD_WARN");
          trustDoubleBeep();
          for (int i = 0; i < totalLeds; i++) {
            mcp_digitalWrite(getLedPin(i), HIGH);
          }
          feedTaskWatchdog();
          delay(120);
          for (int i = 0; i < totalLeds; i++) {
            mcp_digitalWrite(getLedPin(i), LOW);
          }
        }
      } else if (holdMs >= DUAL_BUTTON_DEV_HOLD_MS) {
        if (setDevModeEnabled(true)) {
          Serial.printf("DEV mode toggled via hardware hold: %d\n", devModeEnabled ? 1 : 0);
          sendSerialToBLE(String("DEV_MODE_HW_TOGGLE:") + String(devModeEnabled ? 1 : 0));
        } else {
          Serial.println("DEV mode hardware toggle failed: NVS persist error");
          sendSerialToBLE("DEV_MODE_HW_TOGGLE_ERR:PERSIST_FAIL");
        }
        dualButtonHoldActive = false;
        batteryDisplayMode = false;
        bothButtonsPressed = false;
        factoryRollbackHoldWarned = false;
        for (int i = 0; i < totalLeds; i++) {
          mcp_digitalWrite(getLedPin(i), LOW);
        }
      }
    }
  } else if (!bothButtonsPressedNow) {
    if (bothButtonsPressed) {
      if (bothButtonsReleaseStartMillis == 0) {
        bothButtonsReleaseStartMillis = millis();
      }
      if (millis() - bothButtonsReleaseStartMillis >= DUAL_BUTTON_RELEASE_DEBOUNCE_MS) {
        bothButtonsPressed = false;
        dualButtonHoldActive = false;
        factoryRollbackHoldWarned = false;
        bothButtonsReleaseStartMillis = 0;
      }
    } else {
      bothButtonsReleaseStartMillis = 0;
    }
  } else {
    bothButtonsReleaseStartMillis = 0;
  }

  if (batteryDisplayMode && !bothButtonsPressedNow &&
      (millis() - batteryDisplayStartTime > 3000)) {
    batteryDisplayMode = false;
    for (int i = 0; i < totalLeds; i++) {
      mcp_digitalWrite(getLedPin(i), LOW);
    }
  }

  if (isFlushing) {
    if (flushStep == FLUSH_STEP_CANCEL_COOL) {
      // Cancel recovery cooling in progress; ignore further cancel presses.
    } else if (bothButtonsPressedNow) {
      // Dual-button cancel handled above (bypasses flushCancelArmed).
    } else if (!flushCancelInputActive) {
      flushCancelArmed = true;
    } else if (flushCancelArmed) {
      bool continueFlushRecovery = acceptFlushCancel(button1Pressed, button2Pressed);
      feedTaskWatchdog();
      delay(1);
      if (!continueFlushRecovery) {
        return;
      }
    } else {
      // Ignore the held start/cancel inputs until every cancel source is released once.
      button1Pressed = false;
      button2Pressed = false;
      button1Held = false;
      button1DelayActive = false;
      button2DelayActive = false;
    }
  }

  // Handle individual button presses only if not in battery display mode or dual-button hold
  if (!batteryDisplayMode && !bothButtonsPressedNow && !bothButtonsPressed) {
    // Trust handshake: GPIO2 wake line confirms trust during TRUST_WAITING
    if (g_trustState == TRUST_STATE_WAITING && readControlPanelWakeLine()) {
      onTrustConfirmedByFlushButton();
      SerialBLE_println("Trust confirmed via GPIO2 wake line");
    } else
    // Handle button 1 (Flush) - check for hold to enable cutBag
    if (button1Pressed && !button1WasPressed) {
      SerialBLE_println("Button 1 just pressed - start delay timer");
      // Button 1 just pressed - start delay timer
      button1PressStartTime = millis();
      button1DelayActive = true;
      button1DisconnectAlertedForCurrentPress = false;
      Serial.println("Button 1 pressed - waiting for delay/hold detection");
    } else if (button1Pressed && button1DelayActive && (millis() - button1PressStartTime >= BUTTON_DELAY)) {
      // Delay passed, now start timing for hold detection
      button1DelayActive = false;
      button1HoldStartTime = millis();
      button1Held = true;
      SerialBLE_println("Flushing Pressed");
      Serial.printf("DEBUG: Button 1 delay passed, starting hold timer at %lu\n", button1HoldStartTime);
      // Don't start flush sequence immediately - wait to see if it's a hold
    } else if (button1Pressed && button1Held && (millis() - button1HoldStartTime >= BUTTON_HOLD_TIME)) {
      // Button 1 held long enough - enable cutBag and start flush sequence
      if (!isFlushing && !motorHomingActive && !motorHomingDeferred) {
        if (isHardwareLikelyDisconnectedForUserAction()) {
          if (!button1DisconnectAlertedForCurrentPress) {
            SerialBLE_println("Hardware not connected (thermistor open) - flush blocked");
            playHardwareNotConnectedAlert();
            button1DisconnectAlertedForCurrentPress = true;
          }
        } else {
          if (!isFlushAllowedByBattery(true)) {
            char blockMsg[96];
            snprintf(blockMsg, sizeof(blockMsg),
                     "Flush blocked: usable=%d%% threshold=%d%% vIdle=%.2f vLoad=%.2f",
                     batteryAssessment.usablePercent,
                     batteryThreshold,
                     batteryAssessment.vIdle,
                     batteryAssessment.vLoadWorst);
            Serial.println(blockMsg);
            SerialBLE_println(blockMsg);
            streamBatteryAssessReport("flush_blocked");
            showBatteryLevelFeedback(batteryAssessment.usablePercent, false);
            button1DisconnectAlertedForCurrentPress = true;
            button1Held = false;
            button1DelayActive = false;
            return;
          }

          cutBag = true;
          SerialBLE_println("Cut Bag mode enabled!");
          Serial.printf("DEBUG: cutBag set to true, hold time: %lu ms\n", millis() - button1HoldStartTime);
          flushStartLEDAnimation();
          
          // Start flush sequence with cut bag enabled
          SerialBLE_println("Starting flush sequence with cut bag enabled");
          
          // Calculate sequence timing and reset LED state (countdown from full bar)
          calculateSequenceTiming();
          ledIndex = totalLeds - 1;
          clockwise = true;
          ledLastUpdateMillis = millis();
          
          flushStep = 0;
          isFlushing = true;
          lastDevFlushStatusLogMillis = 0;
          logDevFlush("flush_event", 0, "start", false);
          flushCancelArmed = false;
          button1Held = false;
          button1DelayActive = false;
          button2DelayActive = false;
          flushStartMillis = millis();
        }
      } else if (!isFlushing && motorHomingDeferred && !motorHomingActive) {
        if (!button1DisconnectAlertedForCurrentPress) {
          SerialBLE_println("Flush blocked: charge battery / homing pending");
          Serial.println("Flush blocked: homing deferred (charge battery)");
          int level = batteryAssessment.valid ? batteryAssessment.usablePercent : 0;
          showBatteryLevelFeedback(level, false);
          button1DisconnectAlertedForCurrentPress = true;
        }
      }
    } else if (!button1Pressed && button1Held) {
      unsigned long holdDuration = millis() - button1HoldStartTime;
      button1Held = false;
      if (holdDuration < BUTTON_HOLD_TIME) {
        SerialBLE_println("Flush requires 0.5s hold");
      }
    }
    
    // Handle button 2 (Feed Down) and motor3 (fan) - single else-if chain to prevent conflicts
    /* One sequential else-if chain handling:
    Button2 just pressed → start delay timer
    Button2 pressed and delay passed → start M2 feed ramp and M3 fan
    Button2 pressed continuously → ramp/hold M2 and animate LEDs
    Button2 just released → stop M2, start fan timer, keep M3 running
    Fan timer active (< fanDuration) → keep M3 running
    Fan timer completed (>= fanDuration) → stop M3
    Default → ensure M3 is stopped (only if not flushing) */
    if (button2Pressed && !button2WasPressed) {
      // Button 2 just pressed - start delay timer
      button2PressStartTime = millis();
      button2DelayActive = true;
      button2DisconnectAlertedForCurrentPress = false;
      SerialBLE_println("Button 2 pressed - waiting for delay before starting feed");
      // Don't change motors yet - wait for delay
    } else if (button2Pressed && button2DelayActive && (millis() - button2PressStartTime >= BUTTON_DELAY)) {
      // Delay passed while button still pressed - start feed immediately at low speed.
      button2DelayActive = false;
      button2FanStartTime = millis();
      if (isHardwareLikelyDisconnectedForUserAction()) {
        if (!button2DisconnectAlertedForCurrentPress) {
          SerialBLE_println("Hardware not connected (thermistor open) - feed blocked");
          playHardwareNotConnectedAlert();
          button2DisconnectAlertedForCurrentPress = true;
        }
        motors.setM2Speed(0);
        setFanSpeed(0);
        fanRunning = false;
        button2FeedStarted = false;
        stopManualFeed();
      } else {
        SerialBLE_println("Feed Down Delay Passed - Starting fan and feed ramp");
        setFanSpeed(400);  // Start M3 fan immediately
        fanRunning = false;
        button2FeedStarted = true;
        startManualFeed();
      }
    } else if (button2Pressed && !button2DelayActive && button2FeedStarted) {
      updateManualFeedRamp();
      static unsigned long lastFeedKeepRunningLog = 0;
      if (millis() - lastFeedKeepRunningLog >= BLE_STATUS_LOG_INTERVAL_MS) {
        SerialBLE_println("b2 pressed, feed ramp running");
        lastFeedKeepRunningLog = millis();
      }
      fanRunning = false;  // Prevent fan timer from interfering
    } else if (button2Pressed && !button2DelayActive && !button2FeedStarted) {
      button2FanStartTime = millis();
    } else if (!button2Pressed && button2WasPressed
               && millis() - lastDualButtonEdgeMillis < DUAL_BUTTON_EDGE_GUARD_MS) {
      // Ignore spurious release after dual-button stop (MCP read flicker).
      button2WasPressed = false;
      fanRunning = false;
    } else if (!button2Pressed && button2WasPressed) {
      // Button 2 just released - stop feed motor, start fan timer
      SerialBLE_println("Feed Down Released - Stopping feed, starting fan timer");
      stopManualFeed();
      button2FeedStarted = false;  // Reset flag for next button press
      button2DisconnectAlertedForCurrentPress = false;
      button2FanStartTime = 0;
      fanStartTime = millis();  // Start fan timer
      fanRunning = true;        // Set fan running flag
      //setFanSpeed(255);  // Keep fan running during timer
    } else if (!button2Pressed && fanRunning && (millis() - fanStartTime < fanDuration * 1000)) {
      // Throttle keep-running status logs to avoid BLE spam in the loop.
      static unsigned long lastFanKeepRunningLog = 0;
      if (millis() - lastFanKeepRunningLog >= BLE_STATUS_LOG_INTERVAL_MS) {
        SerialBLE_println("b2 not pressed, fan running, no time out - keep running ");
        lastFanKeepRunningLog = millis();
      }
      // Fan timer is active - keep M3 running
      //setFanSpeed(255);  // Keep fan running
    } else if (!button2Pressed && fanRunning && (millis() - fanStartTime >= fanDuration * 1000)) {
      // Fan timer completed - stop fan
      SerialBLE_println("b2 not pressed, fan running, time out ");
      Serial.println("Fan timer completed - stopping fan");
      setFanSpeed(0);  // Stop M3 motor/fan
      fanRunning = false;  // Clear fan running flag
    } else {
      // Default: button not pressed, no active fan - ensure M3 (fan) is stopped
      // Only if not flushing (flush sequence controls M3 during flush)
      if (!isFlushing) {
        setFanSpeed(0);
        //SerialBLE_println("stopping fan - no conditions met and not flushing");
        fanRunning = false;
      }
      
    }
  }  // Close if (!batteryDisplayMode)
  
  // Clear delay flags if buttons released before delay completes
  if (!button1Pressed && button1DelayActive) {
    button1DelayActive = false;
    button1DisconnectAlertedForCurrentPress = false;
    Serial.println("Button 1 released before delay - cancelled");
  }
  if (!button2Pressed && button2DelayActive) {
    button2DelayActive = false;
    button2DisconnectAlertedForCurrentPress = false;
    Serial.println("Button 2 released before delay - cancelled");
  }
  
  button1WasPressed = button1Pressed;
  button2WasPressed = button2Pressed;

  // Inactivity deep sleep: 2 minutes with no activity, wake on GPIO2 (controlPanelWake)
  // Only enter when wake button is released (HIGH) so pin does not trigger immediate wake.
  // Fan pins are held LOW for legacy boards where fan power may be bypassed.
  if (!devModeEnabled && !otaEnabled && !batteryDisplayMode && !isFlushing && !motorHomingActive &&
      !mechanismMotorRunning && !fanRunning &&
      (millis() - lastActivityMillis >= INACTIVITY_SLEEP_MS) &&
      (digitalRead(controlPanelWake) == HIGH)) {
    heaterOff();
    unsigned long settleStart = millis();
    while (millis() - settleStart < 5000) {
      setFanSpeed(0);
      motors.setM1Speed(0);
      motors.setM2Speed(0);
      applyHeaterPwmDuty(0);
      feedTaskWatchdog();
      delay(10);
    }

    // Deep sleep uses RTC EXT0 wake. GPIO2 is held HIGH by pull-up and wakes when pulled LOW.
    rtc_gpio_init((gpio_num_t)controlPanelWake);
    rtc_gpio_pullup_en((gpio_num_t)controlPanelWake);
    rtc_gpio_pulldown_dis((gpio_num_t)controlPanelWake);
    esp_sleep_enable_ext0_wakeup((gpio_num_t)controlPanelWake, 0);
    prepareFanPinsForDeepSleep();
    if (getErrorLogFileSize() > LOG_SLEEP_TRIM_TRIGGER) {
      trimErrorLogToSize(LOG_TRIM_TARGET);
    }
    esp_task_wdt_reset();
    esp_deep_sleep_start();
  }

  if (heaterOn) {
    updateHeaterPID();
    float heaterTemp = (float)heaterInput;
    unsigned long now = millis();
    if (!isM1MotorActive()) {
      if (heaterTemp > K) {
        timeAboveSetpointMillis += (now - lastHeaterCheckMillis);
      }
      // After cut motor (cut mode): count time above CUT_MODE_TEMP for CUT_MODE_HEAT_TIME
      if (isFlushing && flushStep == 6 && cutBag && case6CutMotorRun) {
        if (heaterTemp >= CUT_MODE_TEMP) {
          timeAboveCutModeTempMillis += (now - lastCutModeTempCheckMillis);
        }
        lastCutModeTempCheckMillis = now;
      }
    }
    lastHeaterCheckMillis = now;
    // In cut-bag flushes, allow headroom relative to the higher cut-mode target.
    // This prevents false overheat trips when K is intentionally lower than CUT_MODE_TEMP.
    float overheatBaseTemp = heaterTargetTemp;
    if (isFlushing && cutBag) {
      overheatBaseTemp = max(K, CUT_MODE_TEMP);
    }
    if (heaterTemp >= overheatBaseTemp * 1.2 && ERROR_CODE == 0) {
      SerialBLE_println("Heater Too Hot - stopping");
      ERROR_CODE = 3;
      stopEverything();
      LEDErrorCode(ERROR_CODE);
    }
  }
  if (isFlushing) {
    flushSequence();
    if (isFlushing && flushStep != 13) {
      if (flushCancelRecoveryActive) {
        maintainCancelRecoveryLeds();
      } else {
        updateLEDs();
      }
    }
  } else if (flushCancelRecoveryActive) {
    maintainCancelRecoveryLeds();
  }
  
  // Stream serial data to BLE if enabled (only when BLE is active)
  if (bleEnabled) {
    streamSerialToBLE();
  }
  
  // Check buttons for direction change only while idle.
  // During flush, LED progress is phase-driven and monotonic.
  if (!isFlushing) {
    if (readControlPanelButton1()) {
      lastActivityMillis = millis();
      clockwise = true;
      ledIndex = 0;
      ledLastUpdateMillis = millis();
    }
    if (readControlPanelButton2()) {
      lastActivityMillis = millis();
      clockwise = false;
      ledIndex = 0;
      ledLastUpdateMillis = millis();
    }
  }
  maintainEEPROMErrorIndicator();
  feedTaskWatchdog();
  delay(1);
}

void flushSequence() {
  unsigned long currentMillis = millis();
  logDevFlushStatusTick();
  
  // Required time above K in seconds (H + CUT_MODE_HEAT_TIME if in cut mode)
  long totalHeaterTime = H;
  if (cutBag) {
    totalHeaterTime += (long)CUT_MODE_HEAT_TIME;
  }
  switch (flushStep) {
    case 0: {
      char preflightMsg[128];
      ledLastUpdateMillis = millis();
      maxHeaterWallTimeMs = 0;  // Reset at start of each flush cycle before recomputing once.
      logPowerTestEvent("flush_preflight", "gate0 start", false);

      bool flushAllowed = false;
      if (!assessBatteryUsable("flush_preflight", true, &flushAllowed)) {
        char reason[96];
        snprintf(reason, sizeof(reason),
                 "gate1_fail usable=%d%% threshold=%d%% vIdle=%.2f vLoad=%.2f",
                 batteryAssessment.usablePercent,
                 batteryThreshold,
                 batteryAssessment.vIdle,
                 batteryAssessment.vLoadWorst);
        latchLowBatteryStop(reason);
        return;
      }
      if (!flushAllowed) {
        char reason[96];
        snprintf(reason, sizeof(reason),
                 "gate1_fail flush_blocked usable=%d%% threshold=%d%%",
                 batteryAssessment.usablePercent,
                 batteryThreshold);
        latchLowBatteryStop(reason);
        return;
      }
      logPowerTestEvent("flush_preflight", "gate1 PASS usable battery ok", true);

      logMotorFaultDebug("flush case0 before fault check");
      checkAllMotorFaults();
      logMotorFaultDebug("flush case0 after fault check");
      if (ERROR_CODE != 0) {
        snprintf(preflightMsg, sizeof(preflightMsg), "gate2_fail error_code=%d", ERROR_CODE);
        logPowerTestEvent("flush_preflight", preflightMsg, true);
        return;
      }
      logPowerTestEvent("flush_preflight", "gate2 PASS motor_faults_ok", false);

      testHeaterCurrent(true);
      if (ERROR_CODE != 0) {
        snprintf(preflightMsg, sizeof(preflightMsg), "gate4_fail error_code=%d", ERROR_CODE);
        logPowerTestEvent("flush_preflight", preflightMsg, true);
        return;
      }
      logPowerTestEvent("flush_preflight", "gate4 PASS all_preflight_ok", true);
      case1FeedStarted = false;  // Reset flag for case 1
      case6CutMotorRun = false;   // Reset flag for case 6 cut motor (run after H, then heat for CUT_MODE_HEAT_TIME)
      timeAboveCutModeTempMillis = 0;
      // Compute timeout once per flush cycle from starting temperature.
      {
        float timeoutCurrentTemp = readTemperature();
        float timeoutTargetTemp = cutBag ? CUT_MODE_TEMP : K;
        float rampSecondsF = (timeoutTargetTemp - timeoutCurrentTemp) / 1.0f;  // 1 C/s ramp assumption
        if (rampSecondsF < 0.0f) {
          rampSecondsF = 0.0f;
        }
        float holdSecondsF = (float)totalHeaterTime;
        maxHeaterWallTimeMs = (unsigned long)((rampSecondsF + holdSecondsF) * 1.2f * 1000.0f);
        Serial.printf("DEBUG: Heater timeout calc (cycle start): current=%.1f C, target=%.1f C, ramp=%.1f s, hold=%.1f s, maxWall=%lu ms\n",
                      timeoutCurrentTemp, timeoutTargetTemp, rampSecondsF, holdSecondsF, maxHeaterWallTimeMs);
      }
      setFlushStep(flushStep + 1);
      SerialBLE_println("Moving to Case1:");
      SerialBLE_println(millis());
      SerialBLE_println("Starting fan, waiting before feed");
      stepStartMillis = currentMillis;
      setFanSpeed(400);  // Start M3 fan immediately
      break;
    }

    case 1:
      currentMillis = millis();
      
      // Start M2 feed motor after preFeedFan delay
      if (!case1FeedStarted && (currentMillis - stepStartMillis >= preFeedFan * 1000)) {
        SerialBLE_println("Pre-feed fan delay complete, starting feed motor");
        motors.setM2Speed(-400);
        case1FeedStarted = true;
      }
      
      // Check if feed time (F) has elapsed (counted from when M2 starts, not from case 1 start)
      if (case1FeedStarted && (currentMillis - stepStartMillis >= (preFeedFan + F) * 1000)) {
        setFlushStep(flushStep + 1);
        SerialBLE_print("Moving to Case2:");
        SerialBLE_println(millis());
        motors.setM2Speed(0);
        // Don't stop M3 here - case 2 will set it to reverse immediately
        stepStartMillis = currentMillis;
      }
      break;

    case 2:
      Serial.println("Close motor on");
      mechanismMotorRunning = true;
      motorStartMillis = millis();
      m1CloseStartTime = millis(); // Record when M1 starts closing
      motors.setM1Speed(400);
      // M3 reverse will start in case 3 after fanReverseStartTime delay
      m3ReverseActive = false; // Reset M3 reverse state
      m3ReverseCompleted = false; // Reset completion flag
      Serial.print("MOTOR START TIME: ");
      Serial.println(motorStartMillis);
      setFlushStep(flushStep + 1);
      SerialBLE_print("Moving to Case3:");
      Serial.println(millis());
      SerialBLE_print("MOTOR START MILLIS: ");
      SerialBLE_println(motorStartMillis);
      break;

    case 3:
      // M3 reverse fan timing during mechanism close (heater starts after case 5)
      
      // Check if it's time to start M3 reverse (based on fanReverseStartTime percentage of typicalOpeningTime)
      if (!m3ReverseActive && !m3ReverseCompleted && m1CloseStartTime > 0) {
        unsigned long delayMs = (unsigned long)((fanReverseStartTime / 100.0) * typicalOpeningTime * 1000);
        if (currentMillis - m1CloseStartTime >= delayMs) {
          SerialBLE_println("Starting M3 reverse");
          setFanSpeed(-400);  // M3 in reverse at full speed
          m3ReverseStartTime = currentMillis;
          m3ReverseActive = true;
        }
      }
      
      // Check if M3 reverse time has elapsed
      if (m3ReverseActive && (currentMillis - m3ReverseStartTime >= fanReverseTime * 1000)) {
        SerialBLE_println("Stopping M3 reverse - time elapsed");
        setFanSpeed(0);
        m3ReverseActive = false;
        m3ReverseCompleted = true; // Mark as completed to prevent restart
      }
      
      setFlushStep(flushStep + 1);
      SerialBLE_print("Moving to Case4:");
      Serial.println(millis());
      break;

    case 4:
        // Continue checking M3 reverse timing in case 4
        // Check if it's time to start M3 reverse (if not started yet)
        if (!m3ReverseActive && !m3ReverseCompleted && m1CloseStartTime > 0) {
          unsigned long delayMs = (unsigned long)((fanReverseStartTime / 100.0) * typicalOpeningTime * 1000);
          if (currentMillis - m1CloseStartTime >= delayMs) {
            SerialBLE_println("Starting M3 reverse (delayed start)");
            setFanSpeed(-400);  // M3 in reverse at full speed
            m3ReverseStartTime = currentMillis;
            m3ReverseActive = true;
          }
        }
        
        // Check if M3 reverse time has elapsed
        if (m3ReverseActive && (currentMillis - m3ReverseStartTime >= fanReverseTime * 1000)) {
          SerialBLE_println("Stopping M3 reverse - time elapsed");
          setFanSpeed(0);
          m3ReverseActive = false;
          m3ReverseCompleted = true; // Mark as completed to prevent restart
        }
        
        case5FeedExecuted = false; // Reset flag when entering case 5
        m1CurrentLogWindowStartMillis = currentMillis;
        m1CurrentMaxInWindow = 0.0;
        setFlushStep(flushStep + 1);
        SerialBLE_print("Moving to Case5:");
        Serial.println(millis());
      break;

    case 5: {
      if (mechanismMotorRunning && (currentMillis - motorStartMillis > TIMEOUT) && ERROR_CODE == 0) {
        SerialBLE_println("Mechanism close timeout in case 5");
        ERROR_CODE = 1;
        stopEverything();
        LEDErrorCode(ERROR_CODE);
        return;
      }

      // Check M3 reverse timing in case 5 (where we wait for mechanism to close)
      // Check if it's time to start M3 reverse (if not started yet and not completed)
      if (!m3ReverseActive && !m3ReverseCompleted && m1CloseStartTime > 0) {
        unsigned long delayMs = (unsigned long)((fanReverseStartTime / 100.0) * typicalOpeningTime * 1000);
        if (currentMillis - m1CloseStartTime >= delayMs) {
          SerialBLE_println("Starting M3 reverse (delayed start in case 5)");
          setFanSpeed(-400);  // M3 in reverse at full speed
          m3ReverseStartTime = currentMillis;
          m3ReverseActive = true;
        }
      }
      
      // Check if M3 reverse time has elapsed
      if (m3ReverseActive && (currentMillis - m3ReverseStartTime >= fanReverseTime * 1000)) {
        SerialBLE_println("Stopping M3 reverse - time elapsed (in case 5)");
        setFanSpeed(0);
        m3ReverseActive = false;
        m3ReverseCompleted = true; // Mark as completed to prevent restart
      }
      
      // Primary check: microswitch closed
        float m1Current = readM1Current();
        if (m1Current > m1CurrentMaxInWindow) {
          m1CurrentMaxInWindow = m1Current;
        }
        if (m1CurrentLogWindowStartMillis == 0) {
          m1CurrentLogWindowStartMillis = currentMillis;
        } else if (currentMillis - m1CurrentLogWindowStartMillis >= M1_CURRENT_LOG_INTERVAL_MS) {
          SerialBLE_print("M1 max current (");
          SerialBLE_print(M1_CURRENT_LOG_INTERVAL_MS / 1000);
          SerialBLE_print("s): ");
          SerialBLE_print(m1CurrentMaxInWindow);
          SerialBLE_println(" A");
          m1CurrentLogWindowStartMillis = currentMillis;
          m1CurrentMaxInWindow = 0.0;
        }
      
      if (digitalRead(microswitchClosePin) == LOW) {
        SerialBLE_println("Microswitch closed");
        
        // Only execute feed once per case 5
        if (!case5FeedExecuted) {
        motors.setM2Speed(-400);
          SerialBLE_println("mechanism closed,feed to relieve strain ");
        delay(300); // feed a bit longer
        motors.setM2Speed(0);
          case5FeedExecuted = true; // Mark as executed
        }
        
        // Normal mode: current > 0.5A is acceptable
        if (m1Current > 0.5) {
          SerialBLE_println("Normal mode: Current > 0.5A confirmed");
        motors.setM1Speed(0);
        setFanSpeed(0);  // Stop M3 motor
        m3ReverseActive = false;  // Clear M3 reverse flag
        mechanismMotorRunning = false; 
        } else {
          SerialBLE_println("Normal mode: Low current detected, waiting for current > 0.5A");
          return; // Stay in case 5 until current threshold met
        }
        
       
        
        SerialBLE_println("switch closed, stop feeding and closing");
        SerialBLE_println("Mechanism closed — starting heat phase");
        mcp_digitalWrite(getLedPin(0), HIGH);
        heaterOn = true;
        heaterTargetTemp = K;
        timeAboveSetpointMillis = 0;
        lastHeaterCheckMillis = currentMillis;
        lastHeaterControlLogMillis = 0;
        stepStartMillis = currentMillis;
        setFlushStep(flushStep + 1);
      }
      break;
    }

    case 6: {
      unsigned long cutDurationMs = (unsigned long)(MOTOR_CUT_TIME * 1000.0f);

      if (case6CutMotorRunning) {
        if (millis() - case6CutMotorStartMillis >= cutDurationMs) {
          motors.setM1Speed(0);
          case6CutMotorRunning = false;
          case6CutMotorRun = true;
          timeAboveCutModeTempMillis = 0;
          lastCutModeTempCheckMillis = millis();
          heaterTargetTemp = CUT_MODE_TEMP;
          SerialBLE_println("Cut motor stopped");
          Serial.printf("DEBUG: Heater target raised to CUT_MODE_TEMP = %.1f °C\n", CUT_MODE_TEMP);
        }
        break;
      }

      if (case6PrecoolCutRunning) {
        if (millis() - case6PrecoolCutStartMillis >= cutDurationMs) {
          motors.setM1Speed(0);
          case6PrecoolCutRunning = false;
          SerialBLE_println("Pre-cooling cut pulse complete");
          setFlushStep(flushStep + 1);
          SerialBLE_print("Moving to Case7 from case 6: ");
          SerialBLE_println(millis());
          SerialBLE_println("Heater off");
          heaterOn = false;
          heaterOff();
          heaterTargetTemp = K;
          stepStartMillis = currentMillis;
          lastCoolingTempLogMillis = 0;
        }
        break;
      }

      if (cutBag && !case6CutMotorRun && (timeAboveSetpointMillis >= (unsigned long)(H * 1000))) {
        SerialBLE_println("Cut bag mode: Running cut motor after H (heater paused during cut motor)");
        Serial.printf("DEBUG: MOTOR_CUT_TIME = %.3f seconds\n", MOTOR_CUT_TIME);
        motors.setM1Speed(400);
        case6CutMotorRunning = true;
        case6CutMotorStartMillis = currentMillis;
        break;
      }

      bool timeAboveKReached;
      if (cutBag) {
        timeAboveKReached = (timeAboveSetpointMillis >= (unsigned long)(H * 1000)) && case6CutMotorRun
                            && (timeAboveCutModeTempMillis >= (unsigned long)(CUT_MODE_HEAT_TIME * 1000));
      } else {
        timeAboveKReached = (timeAboveSetpointMillis >= (unsigned long)(totalHeaterTime * 1000));
      }
      bool maxWallTimeExceeded = ((currentMillis - stepStartMillis) >= maxHeaterWallTimeMs);

      if (timeAboveKReached || maxWallTimeExceeded) {
        if (maxWallTimeExceeded && !timeAboveKReached) {
          Serial.println("WARNING: Heater max wall time reached - temperature did not stay above K for required time");
          SerialBLE_println("WARNING: Heater max time - time above K target not reached");
          if (ERROR_CODE == 0) {
            ERROR_CODE = 6;
            LEDErrorCode(ERROR_CODE);
          }
        } else {
          SerialBLE_println("Heater time complete - Begin cooling");
        }

        if (cutBag && case6CutMotorRun) {
          SerialBLE_println("Cut bag mode: Running pre-cooling cut pulse");
          motors.setM1Speed(400);
          case6PrecoolCutRunning = true;
          case6PrecoolCutStartMillis = currentMillis;
          break;
        }

        setFlushStep(flushStep + 1);
        SerialBLE_print("Moving to Case7 from case 6: ");
        SerialBLE_println(millis());

        SerialBLE_println("Heater off");
        heaterOn = false;
        heaterOff();
        heaterTargetTemp = K;
        stepStartMillis = currentMillis;
        lastCoolingTempLogMillis = 0;
      }
      break;
    }

    case 7: {
      float coolingTemp = readTemperature();
      if (currentMillis - lastCoolingTempLogMillis >= COOLING_TEMP_LOG_INTERVAL_MS) {
        SerialBLE_print("Cooling temp: ");
        SerialBLE_print(coolingTemp);
        SerialBLE_println(" C");
        lastCoolingTempLogMillis = currentMillis;
      }

      bool coolingThresholdReached = coolingTemp < COOL_OPEN_TEMP_C;
      bool coolingTimeoutReached = (currentMillis - stepStartMillis) >= (MAX_COOL_WAIT_S * 1000UL);

      if (coolingThresholdReached || coolingTimeoutReached) {
        if (coolingThresholdReached) {
          SerialBLE_print("Cooling threshold reached, opening sealer at ");
          SerialBLE_print(coolingTemp);
          SerialBLE_println(" C");
        } else {
          SerialBLE_print("WARNING: Cooling timeout reached at ");
          SerialBLE_print(coolingTemp);
          SerialBLE_println(" C - opening sealer");
        }
        Serial.print(currentMillis);
        SerialBLE_println("  Cooling complete opening sealer");
        openSwitchLatched = false;
        case10BackupStarted = false;
        case10FanStarted = false;
        mechanismMotorRunning = true;
        motorStartMillis = millis();
        motors.setM1Speed(-400);
        SerialBLE_print("MOTOR START TIME: ");
        Serial.println(motorStartMillis);
        motors.setM2Speed(400);
        setFlushStep(flushStep + 1);
        SerialBLE_print("Moving to Case 8: ");
        SerialBLE_println(millis());
        stepStartMillis = currentMillis;
      }
      break;
    }

    case 8: {
      if (!openSwitchLatched &&
          (currentMillis - motorStartMillis > (unsigned long)maxOpeningTime * 1000UL) &&
          ERROR_CODE == 0) {
        SerialBLE_println("Mechanism open timeout in case 8");
        motors.setM1Speed(0);
        mechanismMotorRunning = false;
        ERROR_CODE = 1;
        stopEverything();
        LEDErrorCode(ERROR_CODE);
        return;
      }

      int sw = digitalRead(microswitchOpenPin);
      // Stop M1 immediately when open switch closes to prevent overshoot
      if (sw == LOW) {
        openSwitchLatched = true;
        motors.setM1Speed(0);
        mechanismMotorRunning = false;
      }
      if (currentMillis - stepStartMillis >= backupTime * 1000) {
        Serial.println("Stop backing bag up");
        motors.setM2Speed(0);
        setFlushStep(flushStep + 1);
        SerialBLE_print("Moving to Case9: ");
        SerialBLE_println(millis());
      }
      break;
    }

    case 9:
      case10FanStarted = false;  // Reset flag for case 10
      case10BackupStarted = false;  // Reset flag for case 10 backup
      setFlushStep(flushStep + 1);
      SerialBLE_print("Moving to Case10: ");
      Serial.println(millis());
      break;

    case 10: {
      if (!openSwitchLatched &&
          (currentMillis - motorStartMillis > (unsigned long)maxOpeningTime * 1000UL) &&
          ERROR_CODE == 0) {
        SerialBLE_println("Mechanism open timeout in case 10");
        motors.setM1Speed(0);
        mechanismMotorRunning = false;
        ERROR_CODE = 1;
        stopEverything();
        LEDErrorCode(ERROR_CODE);
        return;
      }

      int sw10 = digitalRead(microswitchOpenPin);
      if (sw10 == LOW) {
        if (!openSwitchLatched) {
          SerialBLE_println("Open switch latched, open timeout cleared");
        }
        openSwitchLatched = true;
        motors.setM1Speed(0);
        mechanismMotorRunning = false;
      }

      static int lastSw10Logged = -1;
      if (sw10 != lastSw10Logged) {
        Serial.print("sw10:");
        Serial.println(sw10);
        SerialBLE_print("sw10:");
        SerialBLE_println(sw10);
        lastSw10Logged = sw10;
      }

      if (openSwitchLatched) {
        if (!case10BackupStarted) {
          SerialBLE_println("Stop opening, starting backup");
          motors.setM2Speed(400);  // M2 in reverse for backup
          SerialBLE_println("M2 STARTED BACKUP");
          yield();
          case10BackupStartTime = currentMillis;
          case10BackupStarted = true;
        }

        if (case10BackupStarted && (currentMillis - case10BackupStartTime >= backupTimeAfterReopen * 1000)) {
          if (!case10FanStarted) {
            SerialBLE_println("Backup complete, stopping backup and activating fan");
            motors.setM2Speed(0);
            setFanSpeed(400);
            stepStartMillis = currentMillis;
            case10FanStarted = true;
          }
        }

        if (case10BackupStarted && case10FanStarted && (currentMillis - stepStartMillis >= postCoolingFanDuration * 1000)) {
          SerialBLE_println("Fan delay complete, starting feed motors");
          motors.setM2Speed(-400);
          stepStartMillis = currentMillis;
          case10FanStarted = false;
          case10BackupStarted = false;
          openSwitchLatched = false;
          setFlushStep(flushStep + 1);
          SerialBLE_print("Moving to Case11:");
          Serial.println(millis());
        }
      }
      break;
    }

    case 11:
      if (currentMillis - stepStartMillis >= continueFeeder * 1000) {
        SerialBLE_println("STOP Feeding bag, keep fan running");
        motors.setM2Speed(0);
        // Keep M3 running - don't stop it here, case 12 will handle fan duration
        stepStartMillis = currentMillis;
        setFlushStep(flushStep + 1);
        SerialBLE_print("Moving to Case12:");
        SerialBLE_println(millis());
      }
      break;

    case 12:
      if (currentMillis - stepStartMillis >= fanDuration * 1000) {
        SerialBLE_println("STOP fan after fanDuration");
        setFanSpeed(0);// Stop M3 motor/fan
        stepStartMillis = currentMillis;
        setFlushStep(flushStep + 1);
        SerialBLE_print("Moving to Case13:");
        SerialBLE_println(millis());
      }
      break;

    case 13: {
      // Completion cue: all LEDs on/off twice in quick succession.
      const unsigned long completionFlashPhaseMs = 120;
      const unsigned long completionFlashTotalMs = completionFlashPhaseMs * 4;
      unsigned long elapsed = currentMillis - stepStartMillis;
      if (elapsed < completionFlashTotalMs) {
        int phase = (int)(elapsed / completionFlashPhaseMs);
        bool allOn = (phase == 0 || phase == 2);
        for (int i = 0; i < totalLeds; i++) {
          mcp_digitalWrite(getLedPin(i), allOn ? HIGH : LOW);
        }
      } else {
        Serial.println("All LEDs off");
        for (int i = 0; i < totalLeds; i++) {
          mcp_digitalWrite(getLedPin(i), LOW);
        }
        incrementFlushCount();
        logDevFlush("flush_event", 0, "complete", true);
        isFlushing = false;
        setFlushStep(0, false);
        lastDevFlushStatusLogMillis = 0;
        flushCancelArmed = false;
        cutBag = false;  // Reset cutBag for next cycle
        lastActivityMillis = millis();  // Restart inactivity/sleep timer at end of flush
        SerialBLE_println("Moving to Case0 from 13 - end of sequence:");
        Serial.println(millis());
      }
      break;
    }

    case 14: {
      float coolingTemp = readTemperature();
      if (currentMillis - lastCoolingTempLogMillis >= COOLING_TEMP_LOG_INTERVAL_MS) {
        SerialBLE_print("Cancel recovery cooling temp: ");
        SerialBLE_print(coolingTemp);
        SerialBLE_println(" C");
        lastCoolingTempLogMillis = currentMillis;
      }

      bool coolingThresholdReached = coolingTemp < COOL_OPEN_TEMP_C;
      bool coolingTimeoutReached = (currentMillis - stepStartMillis) >= (MAX_COOL_WAIT_S * 1000UL);

      if (coolingThresholdReached || coolingTimeoutReached) {
        if (coolingThresholdReached) {
          SerialBLE_print("Cancel recovery cooling threshold reached at ");
          SerialBLE_print(coolingTemp);
          SerialBLE_println(" C");
        } else {
          SerialBLE_print("WARNING: Cancel recovery cooling timeout at ");
          SerialBLE_print(coolingTemp);
          SerialBLE_println(" C - starting homing");
        }
        beginCancelRecoveryHoming();
      }
      break;
    }
  }
}

void flashLowBattLeds(int n) {
  for (int i = 0; i < n; i++) {
    mcp_digitalWrite(5, HIGH);
    delay(200);
    mcp_digitalWrite(5, LOW);
    delay(200);
  }
}

void flashLeds() {
  unsigned int duration = 200;
  for (int j = 0; j < 5; j++) {
    for (int i = 0; i < totalLeds; i++) {
      mcp_digitalWrite(getLedPin(i), HIGH);
    }
    delay(duration);
    for (int i = 0; i < totalLeds; i++) {
      mcp_digitalWrite(getLedPin(i), LOW);
    }
    delay(duration);
  }
}

void circleLeds() {
  unsigned int duration = 40;
  for (int i = 0; i < totalLeds; i++) {
    mcp_digitalWrite(getLedPin(i), HIGH);
    delay(duration);
    feedTaskWatchdog();
    mcp_digitalWrite(getLedPin(i), LOW);
    feedTaskWatchdog();
  }
}

void resetFeedButtonLeds() {
  feedLedPatternActive = false;
  feedLedLastUpdateMillis = 0;
  feedLedHeadIndex = 0;
  for (int i = 0; i < totalLeds; i++) {
    mcp_digitalWrite(getLedPin(i), LOW);
  }
}

void updateFeedButtonLeds(bool forceImmediate) {
  unsigned long currentMillis = millis();
  if (!feedLedPatternActive) {
    feedLedPatternActive = true;
    feedLedHeadIndex = 0;
    feedLedLastUpdateMillis = currentMillis;
    forceImmediate = true;
  } else if (!forceImmediate && currentMillis - feedLedLastUpdateMillis < FEED_LED_INTERVAL_MS) {
    return;
  } else if (!forceImmediate) {
    feedLedHeadIndex = (feedLedHeadIndex + totalLeds - 1) % totalLeds;
    feedLedLastUpdateMillis = currentMillis;
  }

  for (int i = 0; i < totalLeds; i++) {
    bool on = false;
    for (int offset = 0; offset < FEED_LED_WINDOW; offset++) {
      if (i == (feedLedHeadIndex + offset) % totalLeds) {
        on = true;
        break;
      }
    }
    mcp_digitalWrite(getLedPin(i), on ? HIGH : LOW);
  }
}

void startManualFeed() {
  manualFeedActive = true;
  manualFeedStartMillis = millis();
  manualFeedLastSpeed = MANUAL_FEED_START_SPEED;
  motors.setM2Speed(manualFeedLastSpeed);
  updateFeedButtonLeds(true);
}

void stopManualFeed() {
  manualFeedActive = false;
  manualFeedStartMillis = 0;
  manualFeedLastSpeed = 0;
  motors.setM2Speed(0);
  resetFeedButtonLeds();
}
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
