rpeter3/toilet_kat_change/SPIKE_PIO/include/good_bootloader.h

#pragma once
#include <stddef.h>
#include <stdint.h>

static const size_t EMBEDDED_BOOTLOADER_LEN = 19984;
static const char EMBEDDED_BOOTLOADER_MD5[] = "e536c176c97b5905286ed980da47abe8";
static const uint8_t EMBEDDED_BOOTLOADER[] = {
  0xE9, 0x03, 0x02, 0x4F, 0xB8, 0x88, 0x3C, 0x40, 0xEE, 0x00, 0x00, 0x00, 0x09, 0x00, 0x00, 0x00,
  0x00, 0xFF, 0xFF, 0x00, 0x00, 0x00, 0x00, 0x01, 0x20, 0x28, 0xCE, 0x3F, 0xCC, 0x10, 0x00, 0x00,
  0x50, 0x00, 0x00, 0x00, 0x01, 0x00, 0x00, 0x00, 0x76, 0x35, 0x2E, 0x35, 0x2E, 0x34, 0x00, 0x00,
  0x00, 0x00, 0x00, 0x00, 0x00, 0x00, 0x00, 0x00, 0x00, 0x00, 0x00, 0x00, 0x00, 0x00, 0x00, 0x00,
  0x00, 0x00, 0x00, 0x00, 0x00, 0x00, 0x00, 0x00, 0x4A, 0x75, 0x6E, 0x20, 0x20, 0x32, 0x20, 0x32,
  0x30, 0x32, 0x36, 0x20, 0x31, 0x31, 0x3A, 0x32, 0x37, 0x3A, 0x32, 0x36, 0x00, 0x00, 0x00, 0x00,
  0x00, 0x00, 0x00, 0x00, 0x00, 0x00, 0x00, 0x00, 0x00, 0x00, 0x00, 0x00, 0x00, 0x00, 0x00, 0x00,
  0x07, 0x00, 0x00, 0x00, 0x78, 0x28, 0xCE, 0x3F, 0x1F, 0x37, 0xCE, 0x3F, 0xC2, 0x00, 0x20, 0x00,
  0xFF, 0xB0, 0xC0, 0x3C, 0x40, 0x08, 0xC1, 0x3C, 0x40, 0x06, 0x24, 0x37, 0xCE, 0x3F, 0x9D, 0x00,
  0x40, 0x00, 0xCF, 0xB0, 0xC0, 0x3C, 0x40, 0x08, 0xC1, 0x3C, 0x40, 0x06, 0x29, 0x37, 0xCE, 0x3F,
  0xEF, 0x00, 0x40, 0x00, 0xFF, 0xE0, 0xC0, 0x3C, 0x40, 0x30, 0xC1, 0x3C, 0x40, 0x09, 0x31, 0x37,
  0xCE, 0x3F, 0xC8, 0x00, 0x60, 0x00, 0xFF, 0xE0, 0xC0, 0x3C, 0x40, 0x30, 0xC1, 0x3C, 0x40, 0x09,
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
  0x6E, 0x74, 0x73, 0x2E, 0x20, 0x4F, 0x6E, 0x6C, 0x79, 0x20, 0x74, 0x68, 0x65, 0x20, 0x6C, 0x61,
  0x73, 0x74, 0x20, 0x6F, 0x6E, 0x65, 0x20, 0x77, 0x69, 0x6C, 0x6C, 0x20, 0x62, 0x65, 0x20, 0x6D,
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
};
