rpeter3/toilet_kat_change/(commit log)

2025-11-15 My FU Toilet branch commit 1
    commit 1
    [partitions.csv]
2026-02-15 The Latest Version merged to the github branch
    This is a working version
    Simplified python bluetooth interface
    Updated material params (known to work for compostable)
    added light sleep functionlaity (deep sleep didn't work due to floating voltages on the fan)
    Committing test screipts for buzzer, fan, motor
    Motor test script will repeatedly stress the motor mechanism
    [material_parameters.csv]
2026-02-15 FEB26_OTA working, tkc NOT WORKING
    This update is before changes to iprove the robustness of both files after TKC dind't update ota with repeated failures
    [p.csv, partitions.csv]
2026-02-15 V2.4.0 - fix virgin EEPROM
    This update ensures the default parameters (not checked which material) are loaded to EEPROM if a virgin magic is detected (magic == 0xFFFF) .
    If the EEPROM is corrupted afterwards it throws an error code and goes into bluetooth mode to wait for an update (to prevent sealing with the wrong parameters)
    THIS IS A RISK - HAS NOT BEEN TESTED
    [toilet_kat_change.ino]
2026-02-15 Fixed BLE OTA update MD5 issue
    fixed the issue where the update would fail after 100% (pita) due to not handling the MD5 hash correctly
    also fixed the slow circle eds and battery indicator
    [toilet_kat_change.ino]
2026-02-16 Corrected BLE OTA
    BLE OTA working and troubleshooted an incorrectly handled MD5 hash.
    minor updates to params and LEDS
    [material_parameters.csv]
2026-02-28 Pre-Production Updates
    No update parameters when llushing
    Change heater to on if temp =K off temp +2C
    motor fault changed to 3 retry then error
    ALWAYS in CUT MODE
    150C FOR EVOH
    ADD CHeck for thermistor resistance on action.
    MAKE COOLING TIME DYNAMIC - 80C (parameter)
    removed motor fault spamming logs.
    [material_parameters.csv, partitions.csv]
2026-03-01 Pre-Production build bug fixes
    LED Timing improved to local phase and global time.
    updated default parameters
    Enforced a 2 degree temperature difference in upp and lower heat thresholds in python interface and firmware.
    Fixed bug where bluetooth timeout while streaming caused reboot.
    [material_parameters.csv]
2026-03-01 More imprevements to PreProd Code
    Added Flush Count in EEPROM
    Added bluetooth interface to flush count
    Changed postcoolignbagduration to postCoolingFANDURATION (bad name) and amended to 1s default for compostable.
    changed description of end of cycle feed time - kept param name
    [material_parameters.csv]
2026-03-01 Initial commit of hardware versioning
    [hardware_version.csv]
2026-03-01 bluetooth communication
    updated bluetooth streaming due to android issues.
    [toilet_bluetooth_interface.py, toilet_kat_change.ino]
2026-03-09 ILLUMINATE LEDSs Test Script for assembly
    separate program for the assembly team to turn on the lights for 2 mintues and test buttons
    [partitions.csv]
2026-03-12 updating QC APP +logging apparently-
    python interface not working...
    [partitions.csv]
2026-03-12 Updated QC test app - working with battery monitoring
2026-03-13 Final Version (pre- final tests)
    Re-Added bluetooth handshakke that was lost
    confirmed logging works (disconnect motor and wait for timeout)
    updated specs of bluetooth
2026-03-17 Working version shipped out at Overland Expo 15 March 2026
    [hardware_version.csv]
2026-03-18 updates
    added regression of battyer level back to the software.
    TODO- fix bluetooth streaming back to the app in chunks
    [partitions.csv]
2026-05-04 Latest Code From Surface pro
    new serial speed on i2c for redued interference
    unknown other changes
    [toilet_kat_change.ino]
2026-06-09 Production Fixes and new control board
    1) Fixed spamming serial BLE with messages
    2) Fixed issue of StopEverything() overwriting the state to 12 every time
    3) Added new control panel setup and hardware
    [diff_output.txt, hardware_version.csv]
2026-06-09 CRITICAL FIX 1
    1. stopEverything() — full standby reset
    Resets flush FSM, motor flags, case flags, M3 reverse state, heater timers, current logging windows, and turns all LEDs off. Does not clear ERROR_CODE.
    2. Both-buttons handler
    Replaced partial motor stop with stopEverything() before entering battery display mode.
    3. enableOTA()
    Removed redundant isFlushing = false (already handled by stopEverything()).
    4. Short-press flush removed
    Flush now requires a 1.5s hold. Early release logs "Flush requires 1.5s hold".
    5. BLE keep-alive
    bleIdleStartTime refreshes when isFlushing; BLE shutdown is blocked during flush.
    6. Motor timeouts relocated
    Removed global loop timeout (~line 3928)
    Case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
    [toilet_bluetooth_interface.py, toilet_kat_change.ino]
2026-06-09 Edge case - switch Open latch case 8&10
    Added latch for the cases 8 & 10 to avoid switch bounce failures.
    [toilet_kat_change.ino]
2026-06-10 NEW HEATER LOGIC and logging
    One-liner: Add WDT/panic forensics logging with SPIFFS fix, RTC_NOINIT snapshot, and GET_LOGS improvements
    Firmware now logs crash diagnostics to SPIFFS and Serial after abnormal reboots (task WDT, panic, brownout, etc.), with pre-crash heater state stored in RTC memory for support via GET_LOGS.
    toilet_kat_change.ino
    logAbnormalResetForensics() + logBootStatus() run after pin init in runHeaterSafetyBootSequence()
    Expanded HeaterSessionRtc (uptime, temp×10, PWM, flush step, cut mode)
    RTC_NOINIT_ATTR so snapshot survives ESP32-S3 task-WDT reset
    Snapshot refreshed during flush heating and in heaterEmergencyShutdown()
    ESP_RST_TASK_WDT treated as abnormal reset; a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
    [toilet_bluetooth_interface.py, toilet_kat_change.ino]
2026-06-10 Fix independent MAX14870 enable and fault handling
    Control M1 and M2 enable/fault pins separately to match the hardware’s two-driver layout, while keeping the existing dual motor speed control path. This ensures both MAX14870 nEN pins are explicitly driven and fault diagnostics report each motor independently.
    [toilet_kat_change.ino]
2026-06-10 HWCFG and Bluetooth
    Add SPIFFS-backed HWCFG storage and manual OTA rollback
    Migrate HWCFG persistence from NVS to SPIFFS for OTA-safe production updates, with legacy NVS fallback migration. Add a trusted manual OTA rollback command, document the BLE protocol changes, and expose a guarded rollback option in the Python client.
    Short version:Add OTA-safe HWCFG storage and rollback support
    Guard BLE wake/restart paths against task watchdog resets
    Add watchdog checkpoints and reset breadcrumbs around BLE setup, OTA BLE restart, and light-sleep wake handling so long BLE stack operations do not trigger false task WDT resets. Preserve the light-sleep resume behavior by documenting that BLE must not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
    [toilet_bluetooth_interface.py, toilet_kat_change.ino]
2026-06-10 non - working change - control panel wake
    issue with wake after light sleep
    [toilet_kat_change.ino]
2026-06-10 FIXED SLEEP FINALLY
    Replace unstable light sleep with deep sleep wake path
    Migrate inactivity sleep to deep sleep so wake follows a clean setup path instead of resuming unstable BLE/I2C/Serial state. Add fan pin deep-sleep hold/release handling to keep legacy fan hardware off during sleep, preserve the 5s pre-sleep settle period, and wake via GPIO2 EXT0.
    SLEEP_TEST was a stripped back test app - we discovered that the timing of recovery from sleep was variable and subject to other libraries - even print serial
    [TEST_SLEEP.ino, toilet_kat_change.ino]
2026-06-11 Updated for the OTA UPDATE
    removed 10s double button press enable OTA -> now enables dev mode to allow the device to remain on permanently
    clean up dev mode parameter names.
    changed the version number
    [material_parameters.csv]
2026-06-16 IMPROVED BATTERY MONITORING AND TESTING
    Added improved battery monitoring
    test of battery power
    additional parameters to configure battery life
    timer on bluetooth ota for restart
    appended hardware matrix to log file (to do - add app version as well)
    improved control panel behaviour
    [material_parameters.csv, partitions.csv]
2026-06-17 ADD_ROLL_BACK_FACTORY_RESET
    Addition of rollback and factory reset functionality following issues with application rollout
    Additional logging around OTA updats
    [partitions_DO_NOT_USE_NO_CORE_DUMP.csv]
2026-06-18 MIGRATION FROM SPIFFS TO LITTLEFS
    [partitions.csv]
2026-06-18 Spike for bootloader overwrite
    [partitions.csv]
2026-06-18 Pinned build version to 3.3.3
    attempting to address memory on ota_0
    minor improvements to build scripts
    [partitions.csv]
